HydroPWNics/footprints/README.md

# footprints
Common Footprint libraries previously stored as part of the analog sensor module repository
