HydroPWNics/footprints/3D/STEP/Molex 73251-1150 Assembly.stp

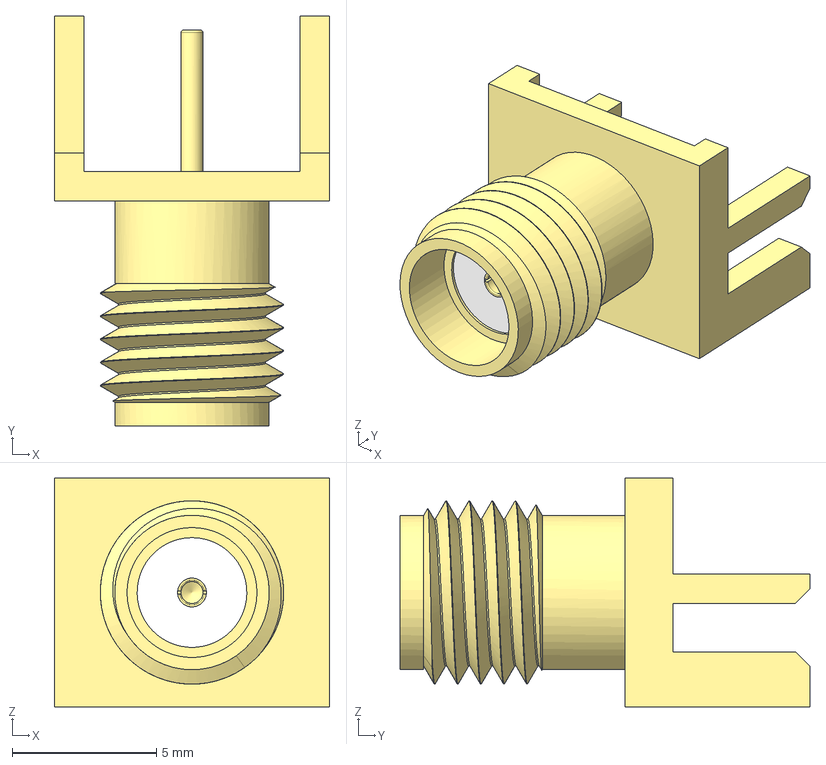
[picture p1: CAD file, 2016-11-11]
3D/STEP/Molex 73251-1150 Assembly.stp
9.53 x 14.2 x 7.93 mm
Molex 73251-1150 Part1
Molex 73251-1150 Part2
Molex 73251-1150 Part3
