HydroPWNics/footprints/3D/STEP/CAP_EEFC_G-M.stp

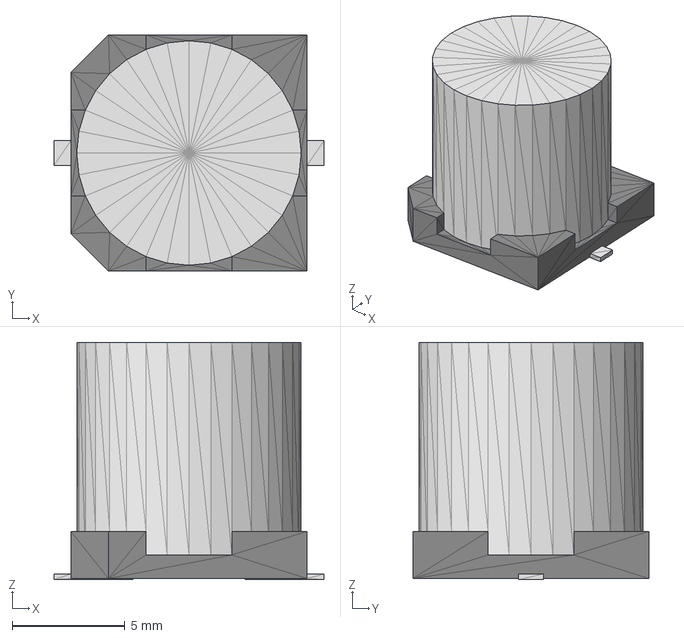
[picture p2: CAD file, 2017-02-14]
3D/STEP/CAP_EEFC_G-M.stp
12.0 x 10.5 x 10.5 mm
