HydroPWNics/footprints/3D/STEP/User Library-tsx-3225-1.step

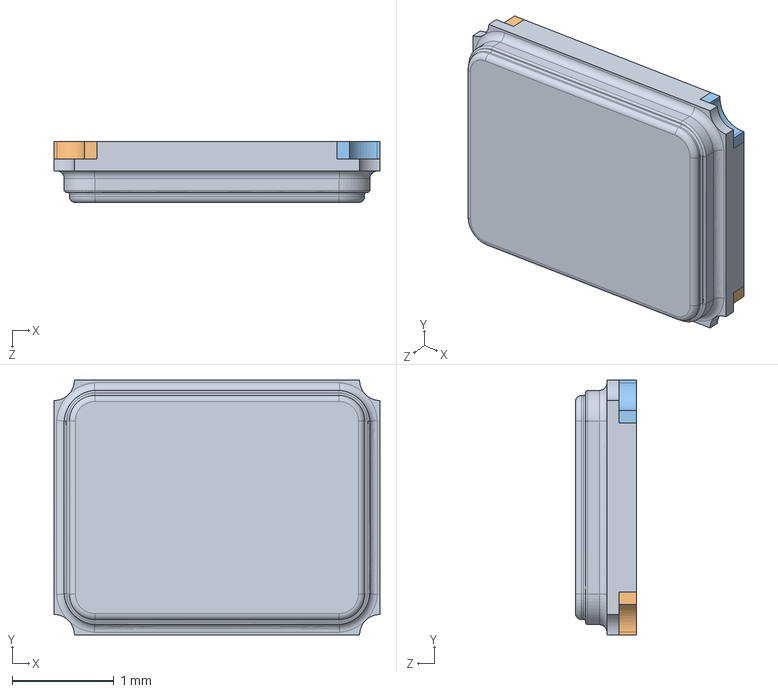
[picture p3: CAD file, 2017-02-06]
3D/STEP/User Library-tsx-3225-1.step
3.20 x 2.50 x 0.6 mm
