HydroPWNics/footprints/3D/STEP/ABS06.STEP

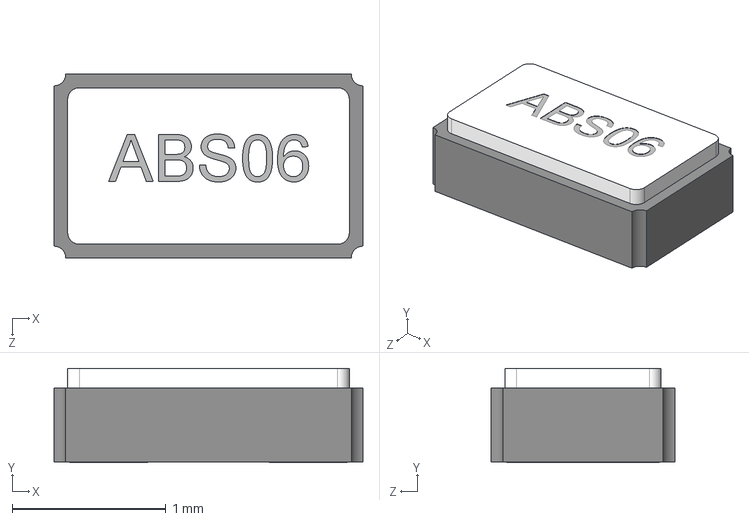
[picture p4: CAD file, 2017-01-24]
3D/STEP/ABS06.STEP
2.01 x 0.612 x 1.19 mm
