HydroPWNics/footprints/3D/STEP/Coilcraft-XAL6030.step

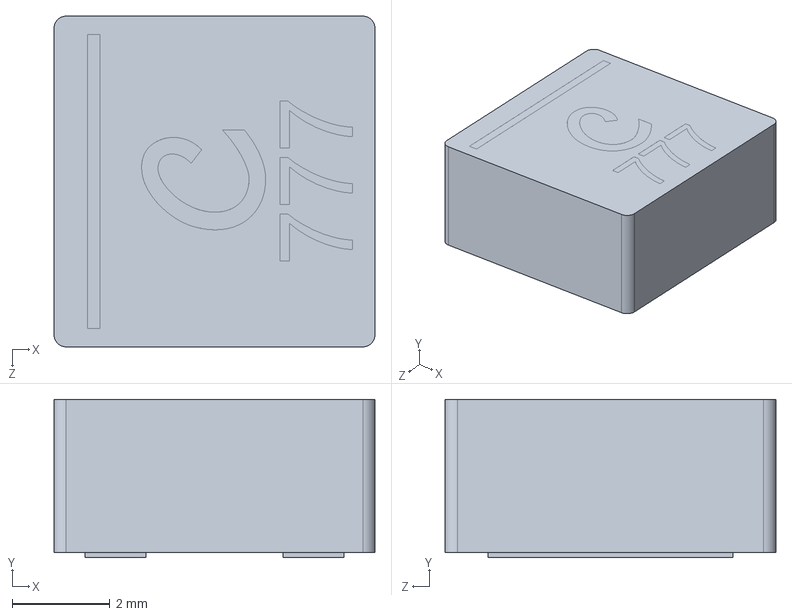
[picture p5: CAD file, 2017-01-24]
3D/STEP/Coilcraft-XAL6030.step
6.56 x 3.23 x 6.76 mm
