HydroPWNics/footprints/3D/STEP/VLCF5020T-100M1R1-1.step

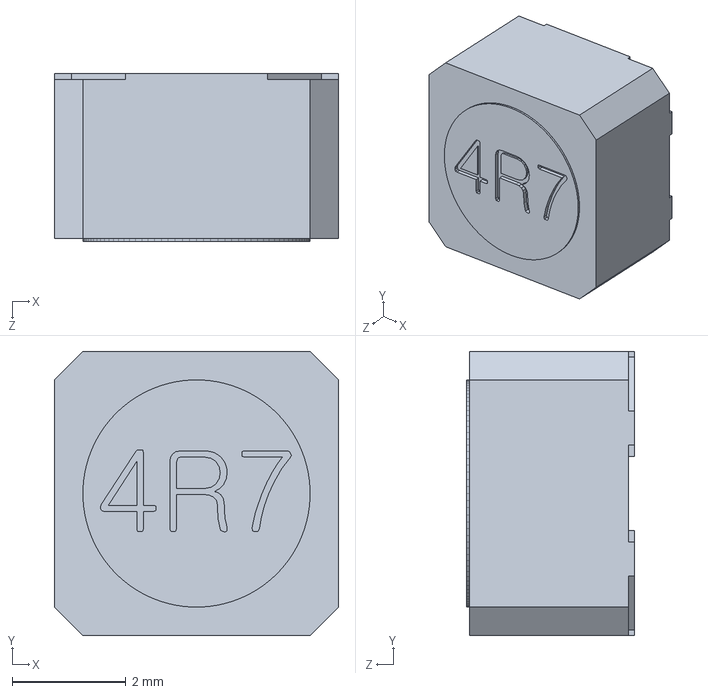
[picture p6: CAD file, 2017-01-24]
3D/STEP/VLCF5020T-100M1R1-1.step
5.00 x 5.00 x 2.95 mm
