HydroPWNics/footprints/3D/STEP/SML-LXLC1206.stp

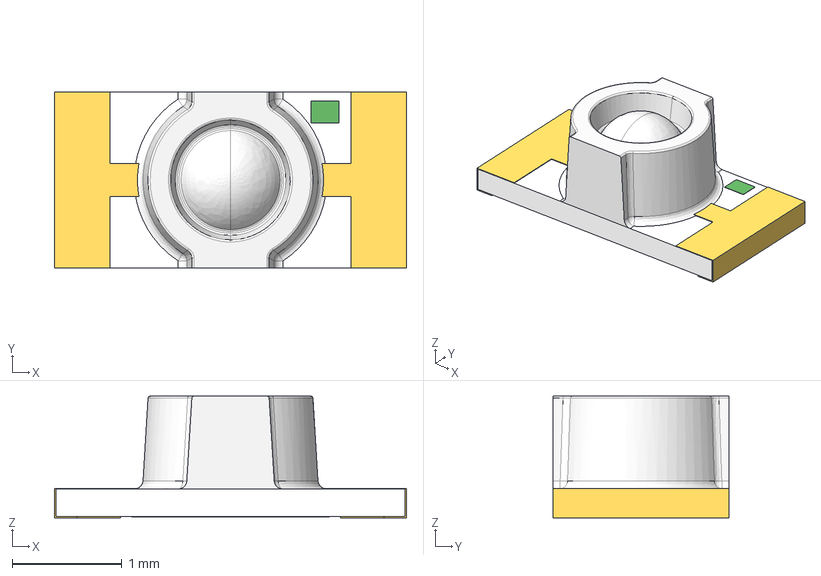
[picture p7: CAD file, 2017-01-13]
3D/STEP/SML-LXLC1206.stp
3.21 x 1.60 x 1.11 mm
