HydroPWNics/footprints/3D/STEP/Coilcraft-LPS3015.step

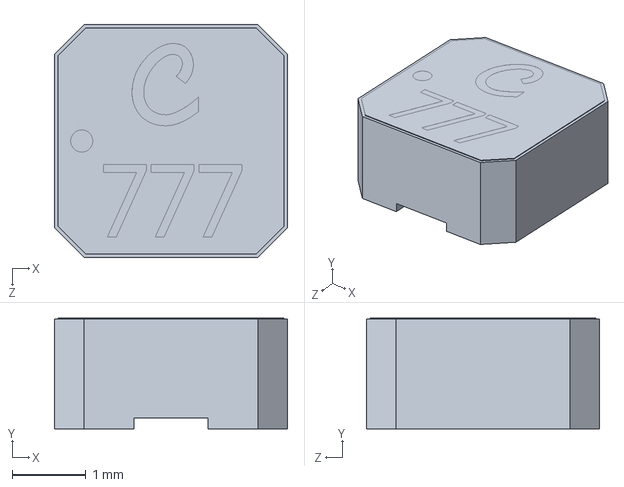
[picture p8: CAD file, 2017-01-09]
3D/STEP/Coilcraft-LPS3015.step
3.16 x 1.50 x 3.16 mm
