HydroPWNics/footprints/3D/STEP/C1210.step

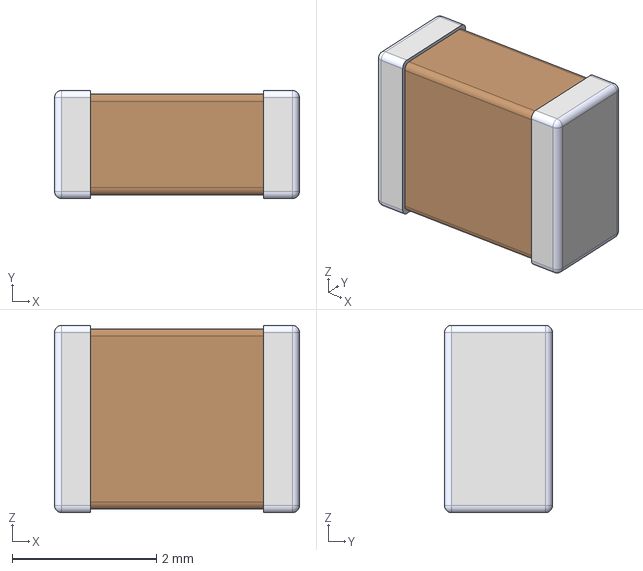
[picture p9: CAD file, 2017-01-09]
3D/STEP/C1210.step
3.40 x 1.50 x 2.60 mm
