HydroPWNics/footprints/3D/STEP/XFL4020.step

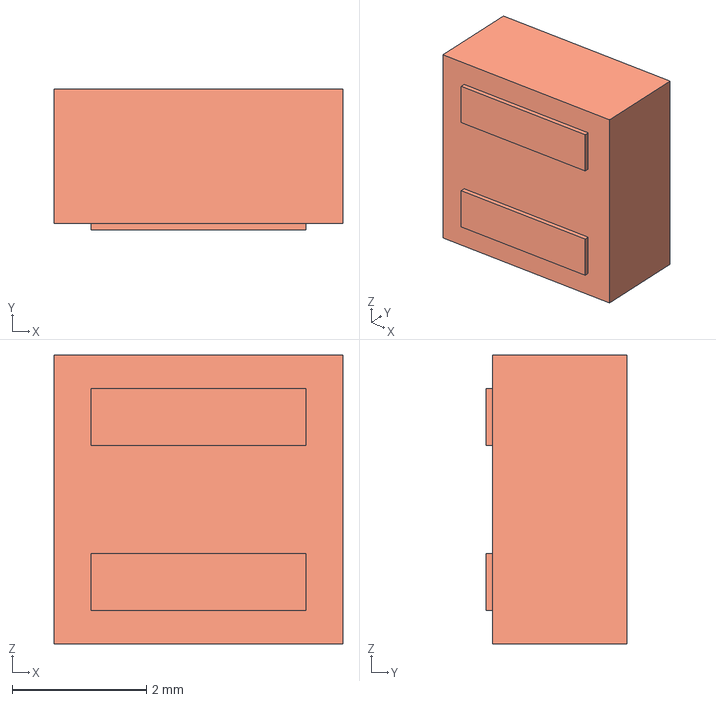
[picture p10: CAD file, 2017-01-09]
3D/STEP/XFL4020.step
4.30 x 2.10 x 4.30 mm
