HydroPWNics/footprints/3D/STEP/LQM2HP_J0.stp

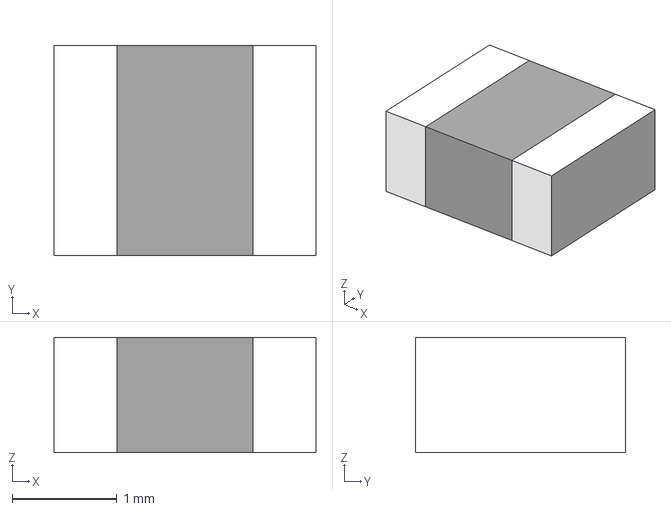
[picture p11: CAD file, 2017-01-09]
3D/STEP/LQM2HP_J0.stp
2.50 x 2.00 x 1.10 mm
