HydroPWNics/footprints/3D/STEP/SOIC4.step

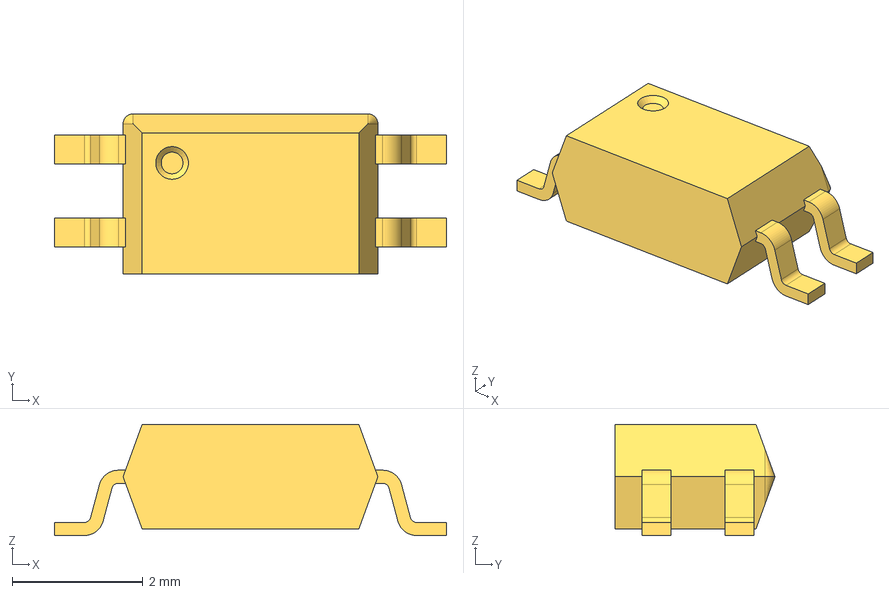
[picture p12: CAD file, 2017-01-04]
3D/STEP/SOIC4.step
6.00 x 2.45 x 1.70 mm
