HydroPWNics/footprints/3D/STEP/User Library-DO-214AA_SMB.step

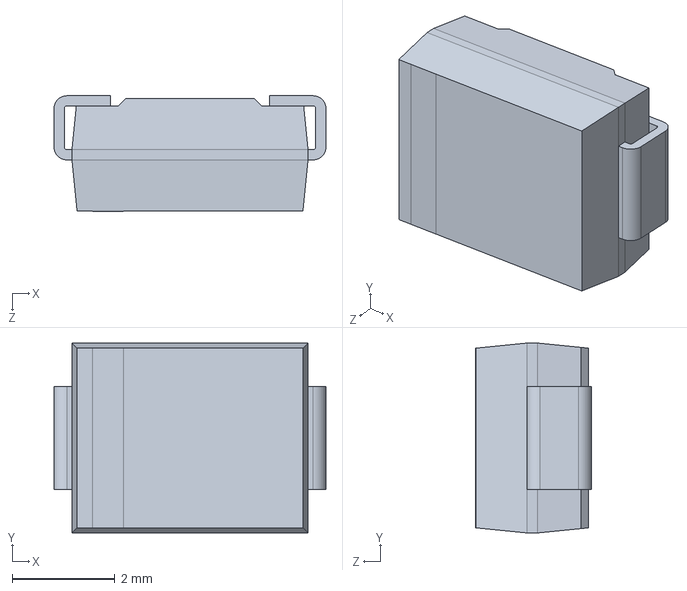
[picture p13: CAD file, 2017-01-04]
3D/STEP/User Library-DO-214AA_SMB.step
5.30 x 3.70 x 2.25 mm
