HydroPWNics/footprints/3D/STEP/1206_RES.stp

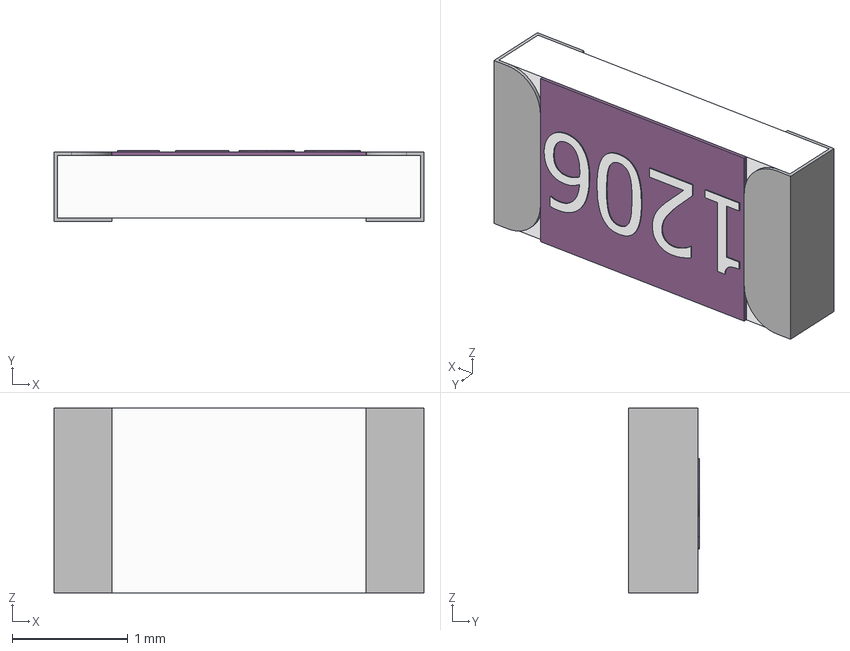
[picture p14: CAD file, 2017-01-04]
3D/STEP/1206_RES.stp
3.20 x 0.61 x 1.60 mm
Capsule
Encapsulation x 2
TopCover
