HydroPWNics/footprints/3D/STEP/0031-7701-11.STEP

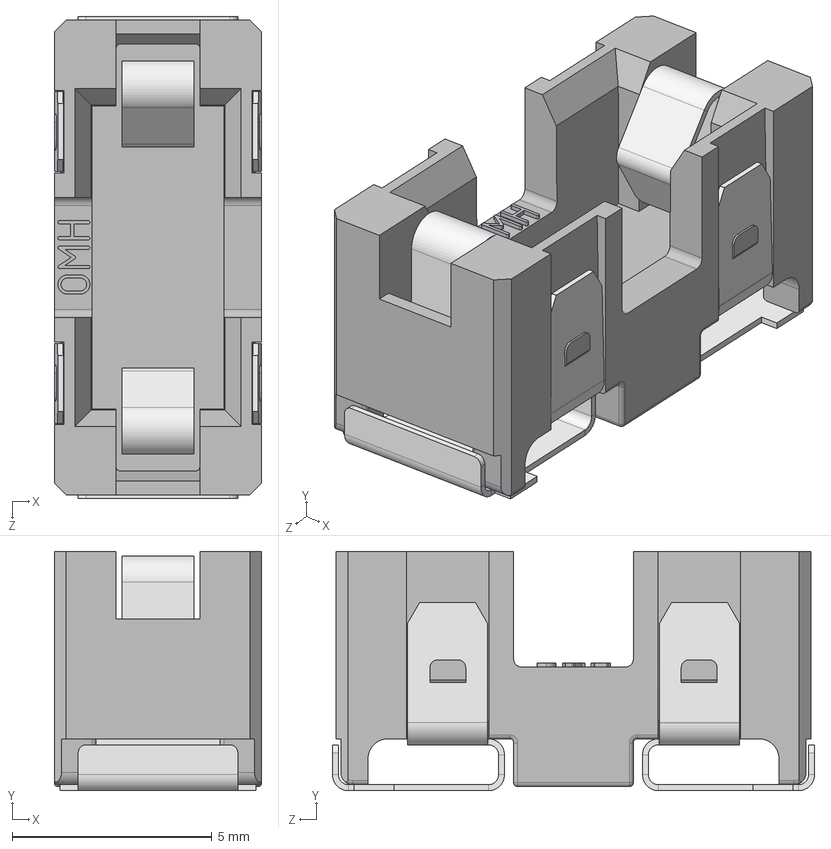
[picture p15: CAD file, 2017-01-04]
3D/STEP/0031-7701-11.STEP
5.20 x 6.00 x 12.1 mm
