HydroPWNics/footprints/3D/STEP/User Library-FSM4JSMATR - TE Connectivity - SPST 6mm Tactile Switch.step

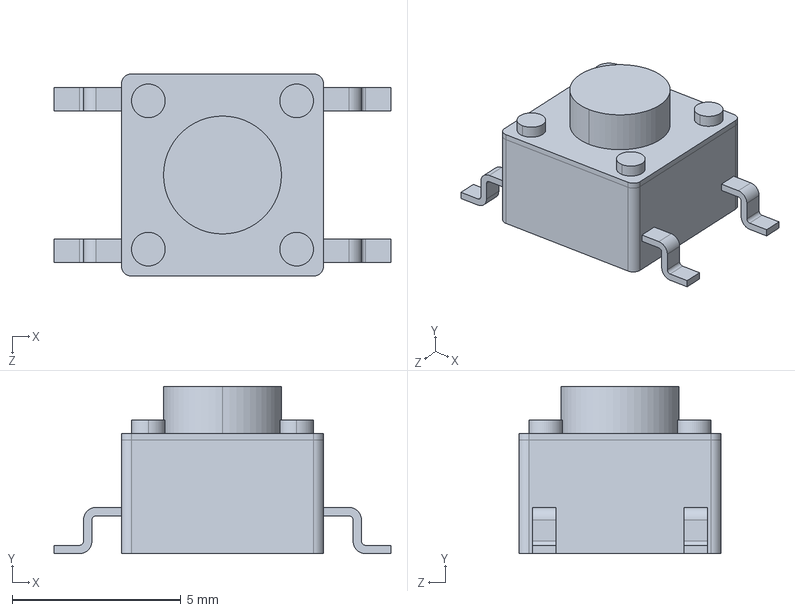
[picture p16: CAD file, 2017-01-04]
3D/STEP/User Library-FSM4JSMATR - TE Connectivity - SPST 6mm Tactile Switch.step
10.0 x 4.97 x 6.00 mm
