HydroPWNics/footprints/3D/STEP/NICHICON_ALU_CAP_1.step

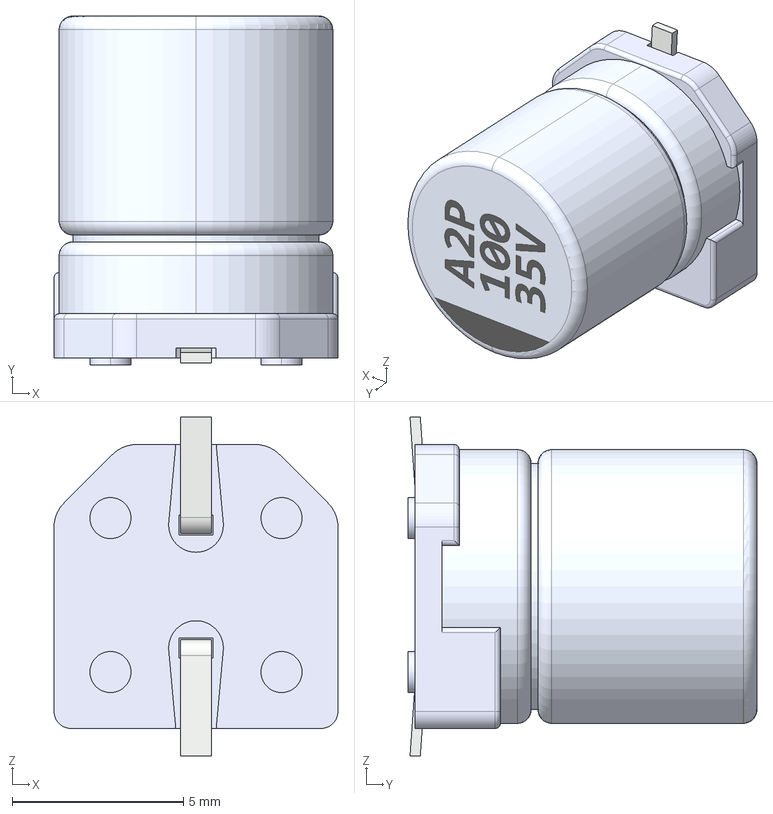
[picture p17: CAD file, 2016-12-30]
3D/STEP/NICHICON_ALU_CAP_1.step
8.30 x 10.2 x 9.90 mm
NICHIKON_UWT1V221MNL1GS
NICHIKON_UWT1V221MNL1GS001
NICHIKON_UWT1V221MNL1GS002
