HydroPWNics/footprints/3D/STEP/ABS05.STEP

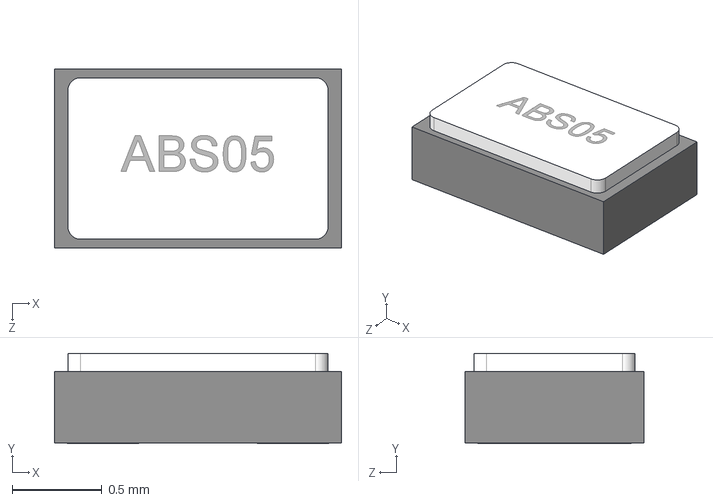
[picture p18: CAD file, 2016-12-30]
3D/STEP/ABS05.STEP
1.60 x 0.503 x 1.00 mm
