HydroPWNics/footprints/3D/STEP/S6B-PH-SM4-TB - S6B-PH-SM4.step

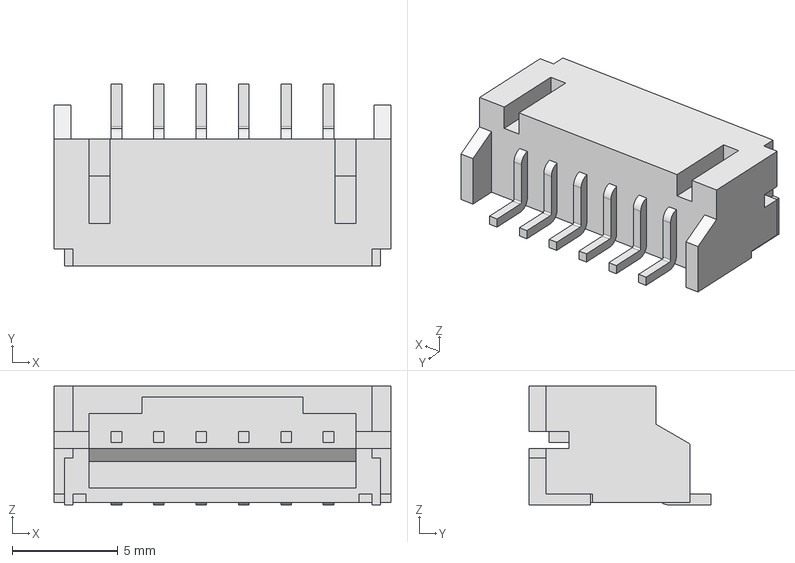
[picture p19: CAD file, 2016-12-30]
3D/STEP/S6B-PH-SM4-TB - S6B-PH-SM4.step
15.9 x 8.60 x 5.60 mm
