HydroPWNics/footprints/3D/STEP/sot-23-6.stp

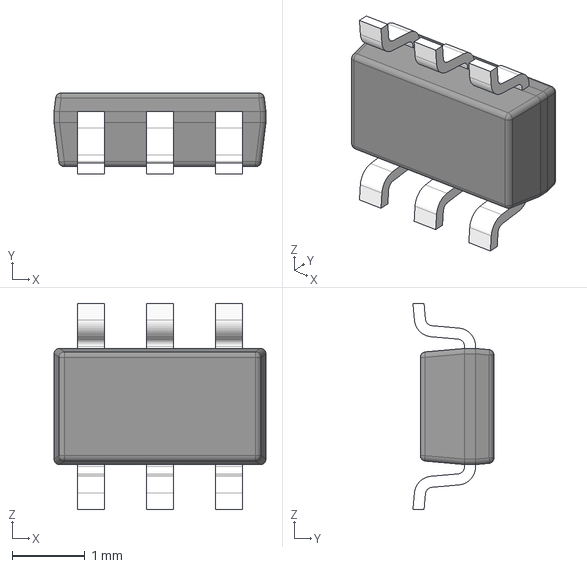
[picture p20: CAD file, 2016-12-30]
3D/STEP/sot-23-6.stp
2.92 x 1.12 x 2.84 mm
BODY_MF06A
LEAD_MF06A x 6
