HydroPWNics/footprints/3D/STEP/User Library-LTST-C193KFKT.step

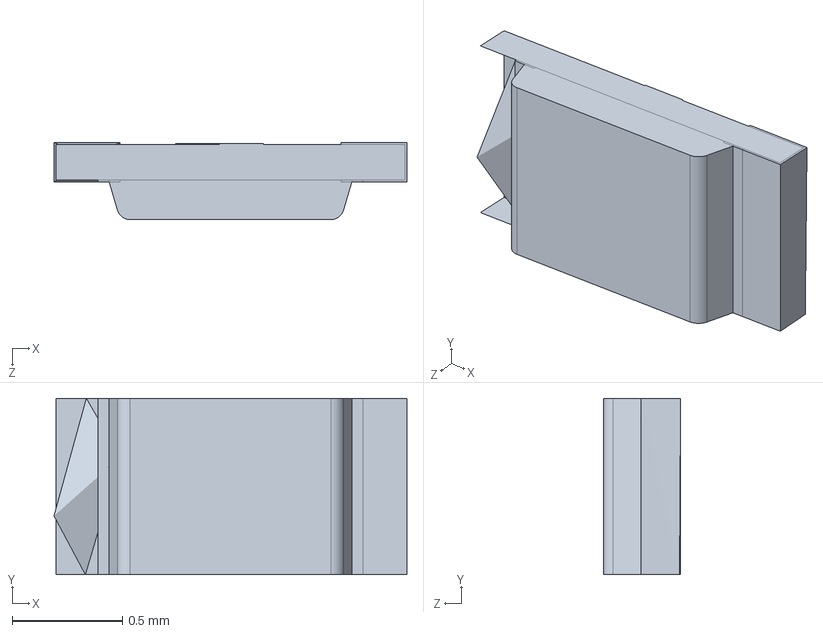
[picture p21: CAD file, 2016-12-30]
3D/STEP/User Library-LTST-C193KFKT.step
1.60 x 0.8 x 0.35 mm
