HydroPWNics/footprints/3D/STEP/S4B-PH-SM4-TB.STEP

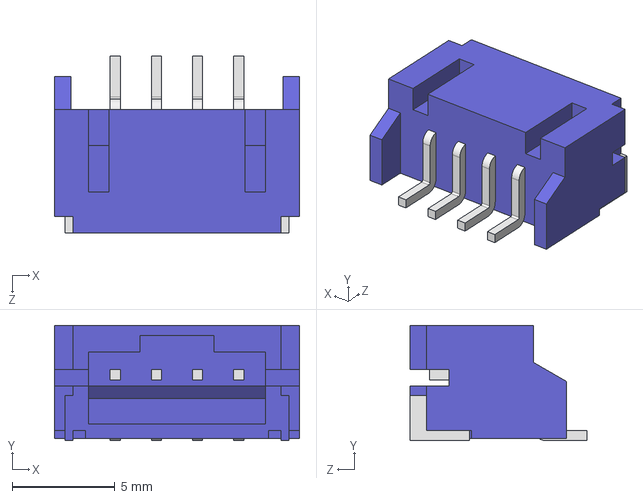
[picture p22: CAD file, 2016-12-30]
3D/STEP/S4B-PH-SM4-TB.STEP
11.9 x 5.60 x 8.60 mm
