HydroPWNics/footprints/3D/STEP/STEP-61301621121-rev1.stp

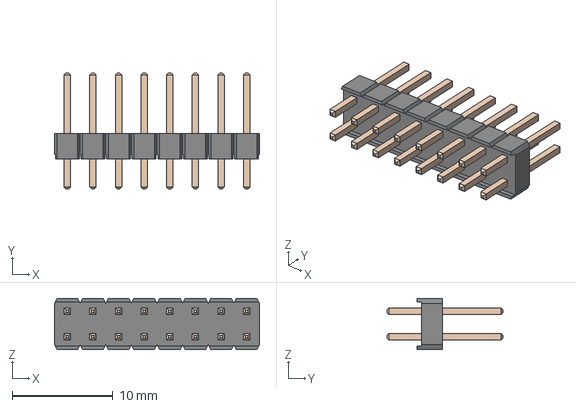
[picture p23: CAD file, 2016-12-30]
3D/STEP/STEP-61301621121-rev1.stp
20.3 x 11.5 x 5.08 mm
6130xx21121_PIN x 16
