HydroPWNics/footprints/3D/STEP/msop-10 - Part 1.step

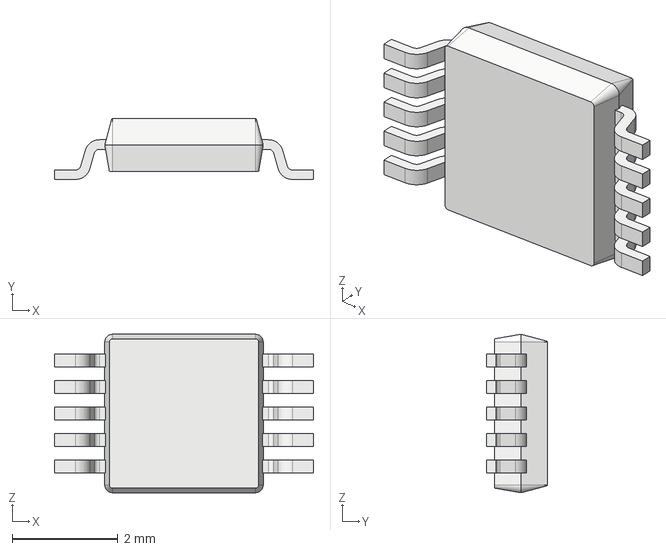
[picture p24: CAD file, 2016-12-30]
3D/STEP/msop-10 - Part 1.step
4.90 x 1.15 x 3.00 mm
