HydroPWNics/footprints/3D/STEP/Coilcraft-XFL3012.step

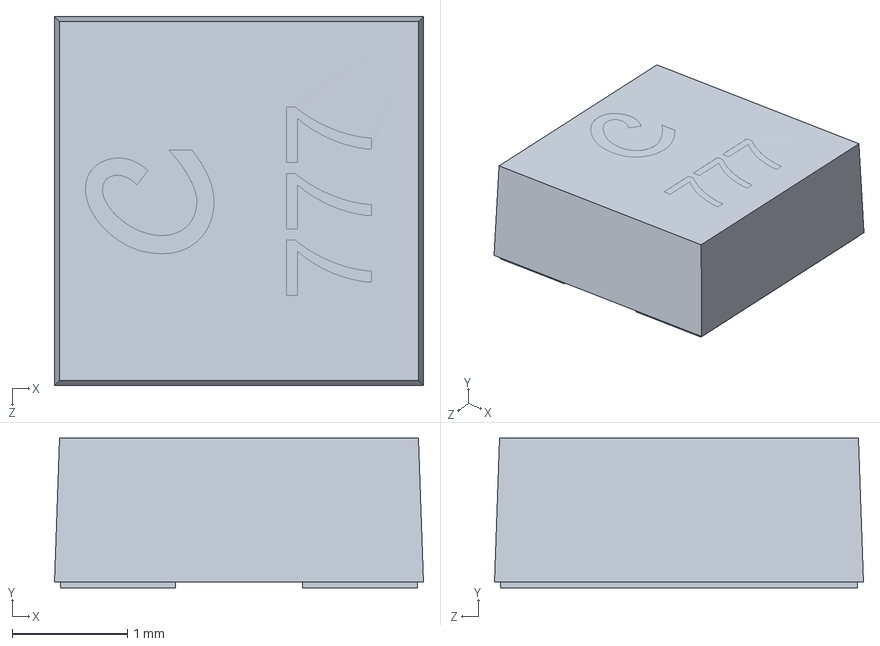
[picture p25: CAD file, 2016-12-30]
3D/STEP/Coilcraft-XFL3012.step
3.20 x 1.30 x 3.20 mm
