HydroPWNics/footprints/3D/STEP/User Library-LTST-C193NBKT.step

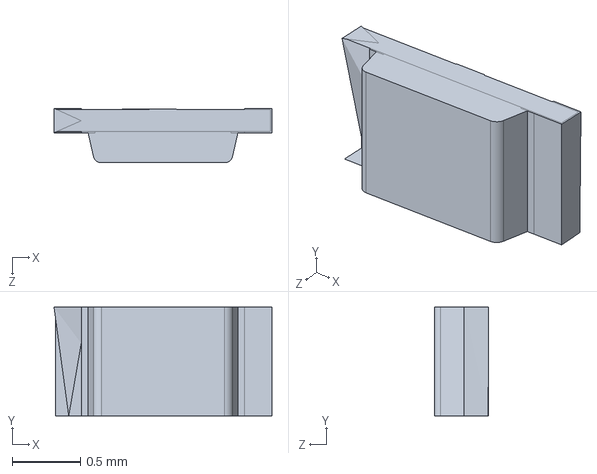
[picture p26: CAD file, 2016-12-30]
3D/STEP/User Library-LTST-C193NBKT.step
1.60 x 0.8 x 0.4 mm
