HydroPWNics/footprints/3D/STEP/TO263-7-1.stp

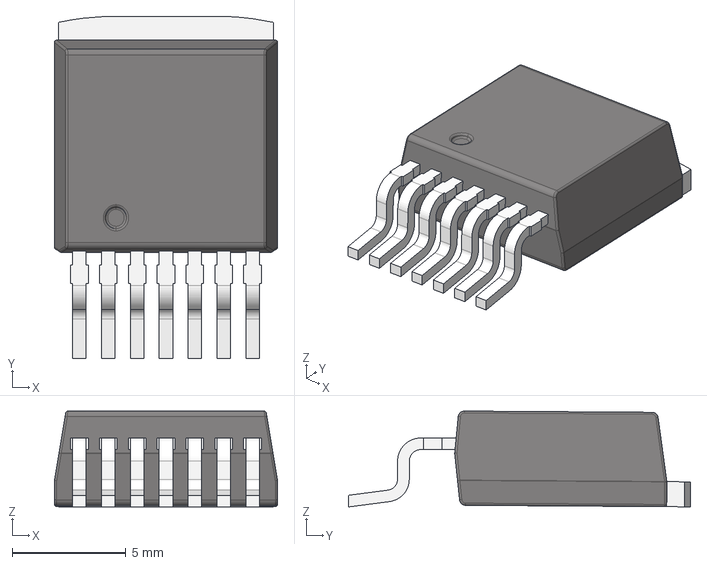
[picture p27: CAD file, 2016-12-30]
3D/STEP/TO263-7-1.stp
9.82 x 15.1 x 4.22 mm
