HydroPWNics/footprints/3D/STEP/STEP-36003200-rev1.stp

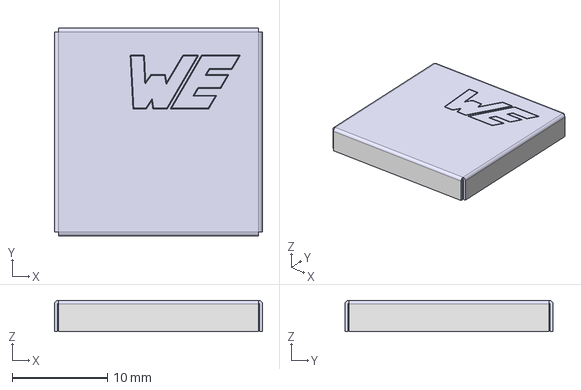
[picture p28: CAD file, 2016-11-11]
3D/STEP/STEP-36003200-rev1.stp
21.8 x 21.8 x 3.30 mm
