HydroPWNics/footprints/3D/STEP/ABM10_AP103.STEP

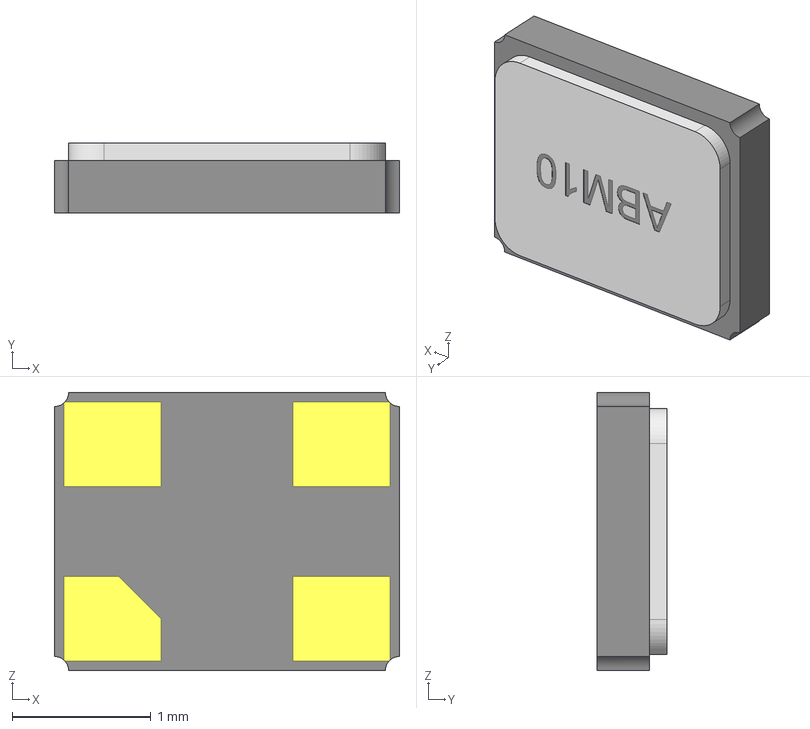
[picture p29: CAD file, 2016-11-11]
3D/STEP/ABM10_AP103.STEP
2.49 x 0.508 x 2.01 mm
