HydroPWNics/footprints/3D/STEP/User Library-ABM11.step

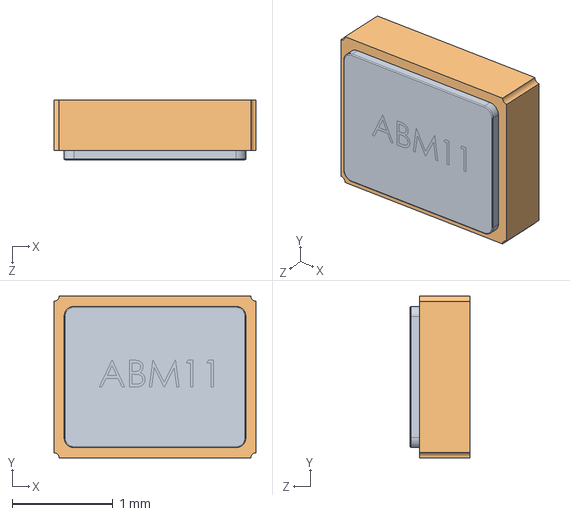
[picture p30: CAD file, 2016-11-11]
3D/STEP/User Library-ABM11.step
2.00 x 1.60 x 0.59 mm
