HydroPWNics/footprints/3D/STEP/MS-026ABA.stp

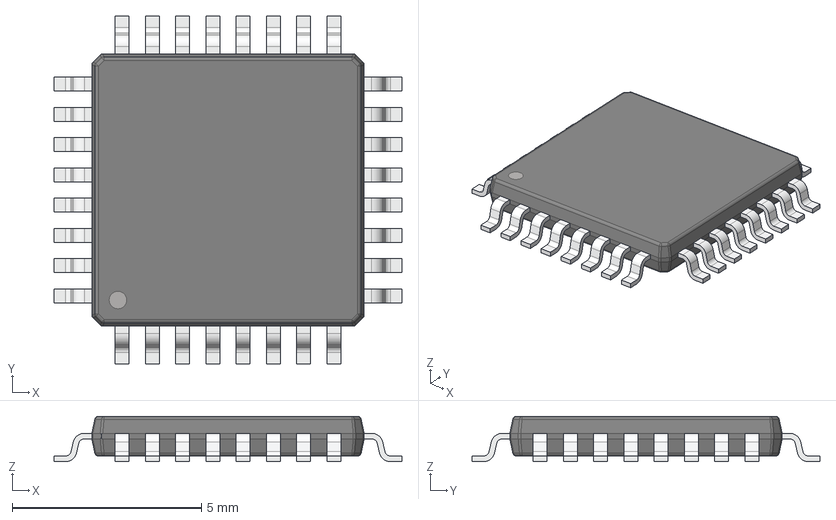
[picture p31: CAD file, 2016-11-11]
3D/STEP/MS-026ABA.stp
9.20 x 9.20 x 1.20 mm
