HydroPWNics/footprints/3D/STEP/Laird BMI-S-209-C.step

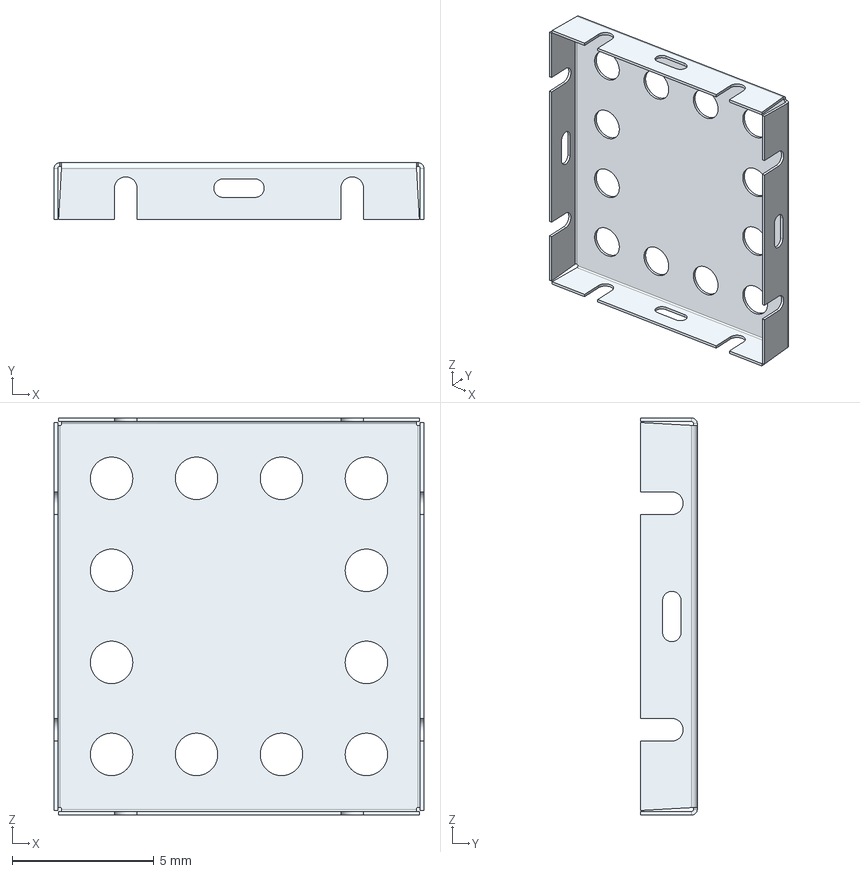
[picture p32: CAD file, 2016-11-11]
3D/STEP/Laird BMI-S-209-C.step
13.1 x 2.00 x 14.0 mm
