HydroPWNics/footprints/3D/STEP/MS-026ACB.stp

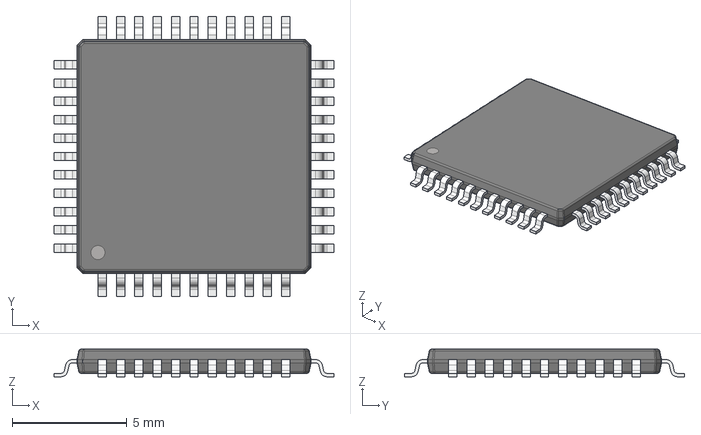
[picture p33: CAD file, 2016-11-11]
3D/STEP/MS-026ACB.stp
12.2 x 12.2 x 1.20 mm
