HydroPWNics/footprints/3D/STEP/TQFP48.step

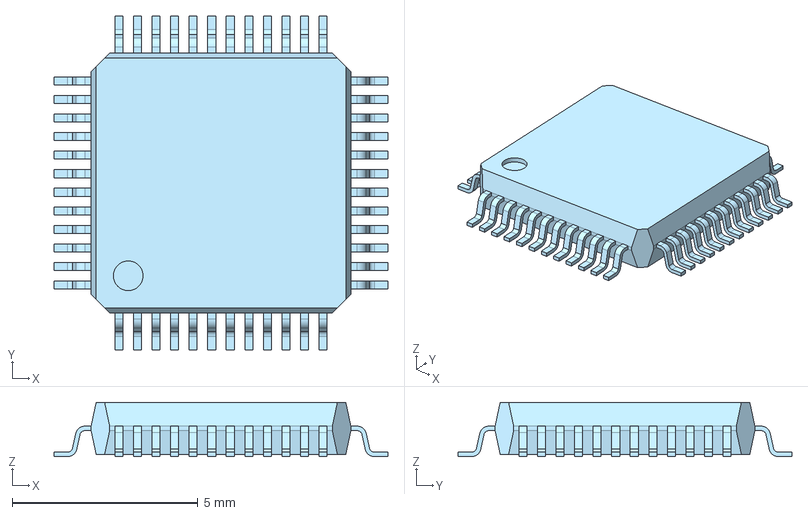
[picture p34: CAD file, 2016-11-11]
3D/STEP/TQFP48.step
9.00 x 9.00 x 1.46 mm
