HydroPWNics/footprints/3D/STEP/MS-026BED.stp

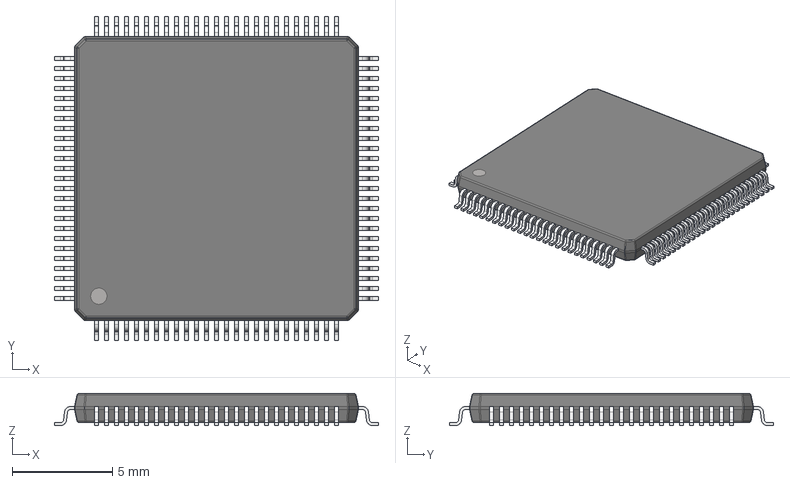
[picture p35: CAD file, 2016-11-11]
3D/STEP/MS-026BED.stp
16.2 x 16.2 x 1.60 mm
