HydroPWNics/footprints/3D/STEP/STEP-36103205-rev1 - 1.step

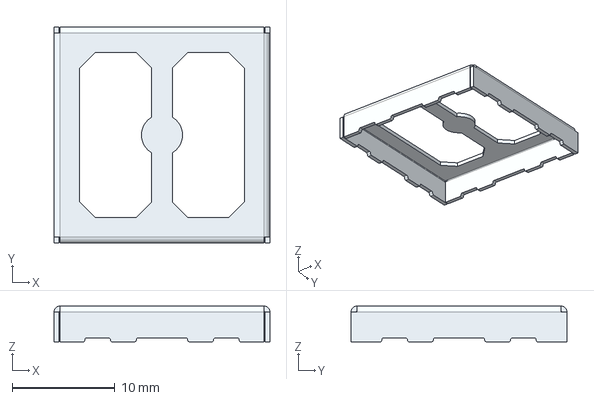
[picture p36: CAD file, 2016-11-11]
3D/STEP/STEP-36103205-rev1 - 1.step
21.0 x 21.0 x 3.50 mm
