HydroPWNics/footprints/3D/STEP/Laird BMI-S-209-F.step

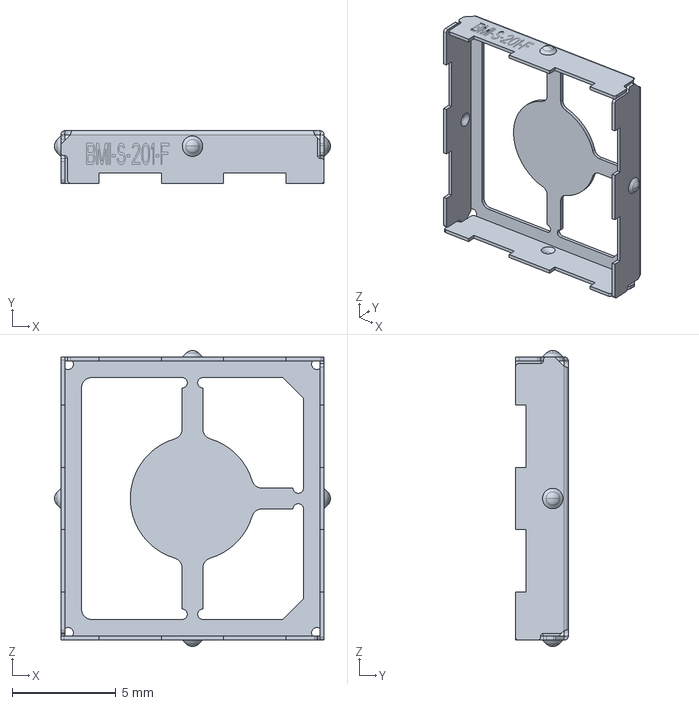
[picture p37: CAD file, 2016-11-11]
3D/STEP/Laird BMI-S-209-F.step
13.3 x 2.54 x 14.3 mm
