HydroPWNics/footprints/3D/STEP/ABM12.step

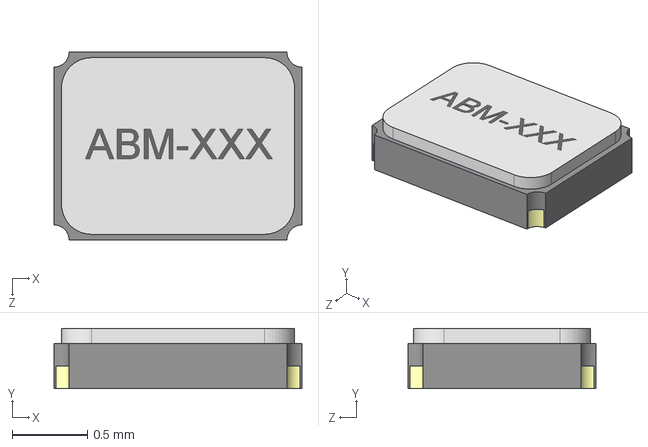
[picture p38: CAD file, 2016-11-11]
3D/STEP/ABM12.step
1.65 x 0.401 x 1.25 mm
