HydroPWNics/footprints/3D/STEP/SM06B-SRSS-TB.STEP

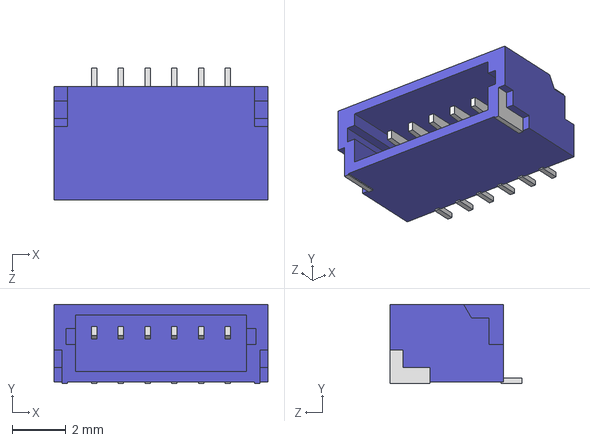
[picture p39: CAD file, 2016-11-11]
3D/STEP/SM06B-SRSS-TB.STEP
8.00 x 2.96 x 4.95 mm
