HydroPWNics/footprints/3D/STEP/TQFP-32_AP103.STEP

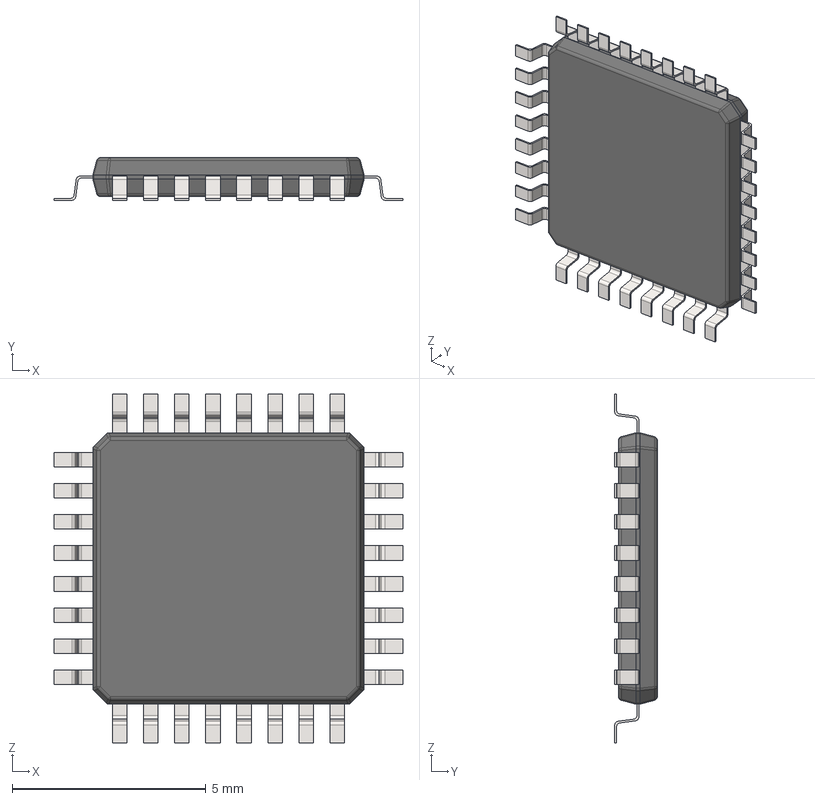
[picture p40: CAD file, 2016-11-11]
3D/STEP/TQFP-32_AP103.STEP
9.00 x 1.10 x 9.00 mm
