HydroPWNics/footprints/3D/STEP/User Library-DFN12(3x3).step

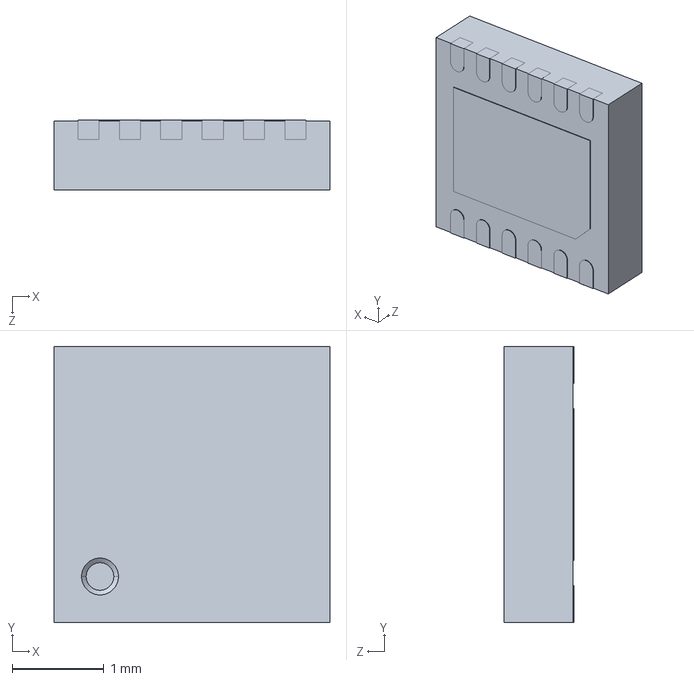
[picture p41: CAD file, 2016-11-11]
3D/STEP/User Library-DFN12(3x3).step
3.00 x 3.00 x 0.76 mm
