HydroPWNics/footprints/3D/STEP/SOT23-5.stp

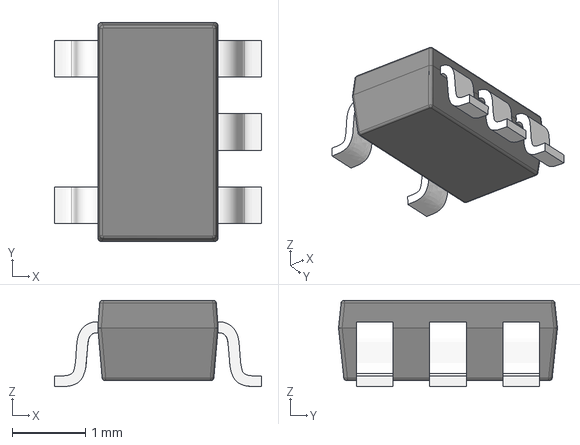
[picture p42: CAD file, 2016-10-31]
3D/STEP/SOT23-5.stp
2.84 x 3.00 x 1.18 mm
