HydroPWNics/footprints/3D/STEP/Johanson_Tech_Balun.step

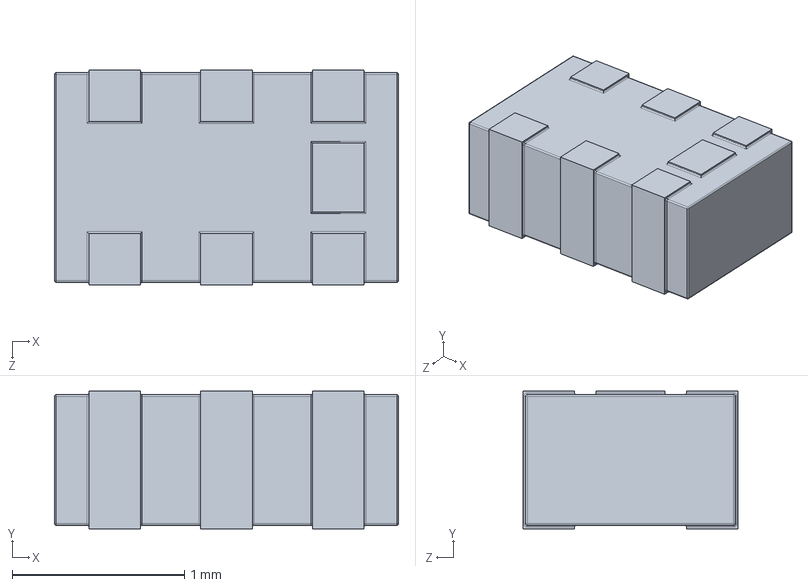
[picture p43: CAD file, 2016-10-30]
3D/STEP/Johanson_Tech_Balun.step
2.00 x 0.8 x 1.25 mm
