HydroPWNics/footprints/3D/STEP/Coilcraft-0402CS.step

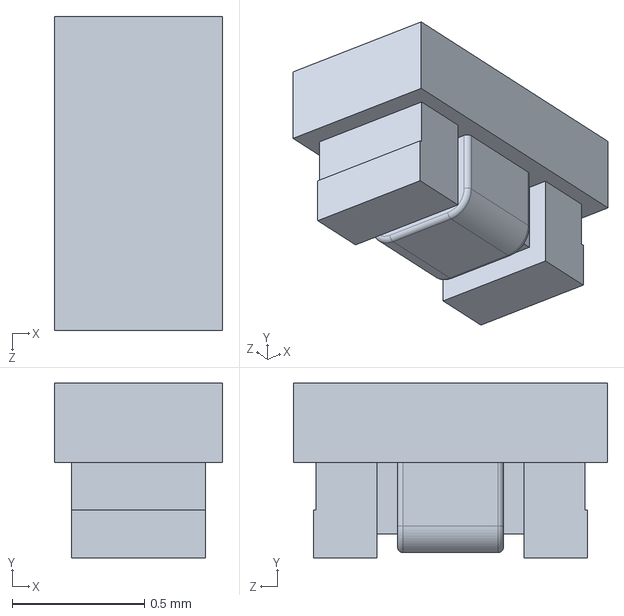
[picture p44: CAD file, 2016-10-29]
3D/STEP/Coilcraft-0402CS.step
0.636 x 0.66 x 1.19 mm
