HydroPWNics/footprints/3D/STEP/CSS-1210TB.stp

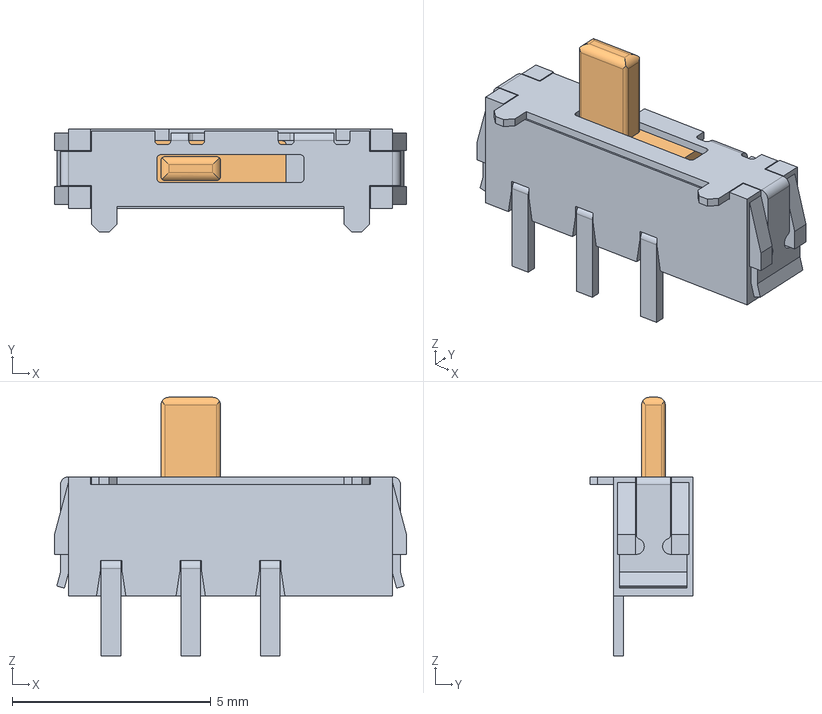
[picture p45: CAD file, 2016-10-28]
3D/STEP/CSS-1210TB.stp
8.85 x 2.60 x 6.50 mm
_CSS-1210TB-b
_CSS-1210TB-s
