HydroPWNics/footprints/3D/STEP/SOIC10 narrow.stp

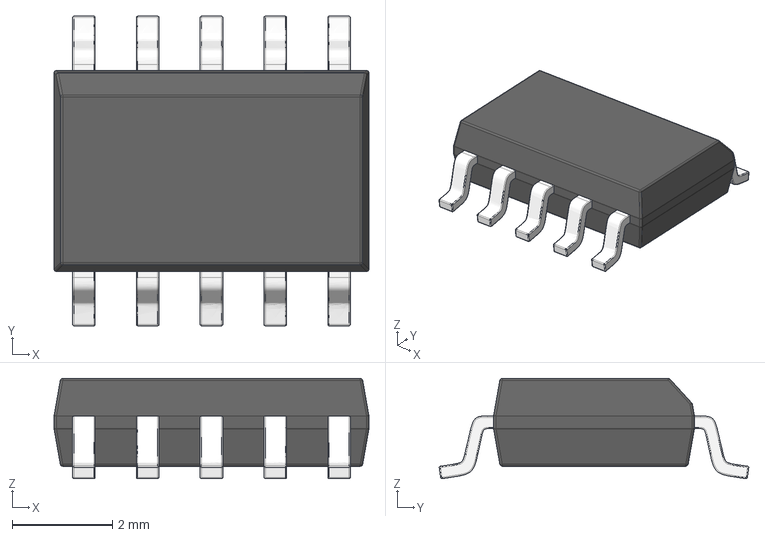
[picture p46: CAD file, 2016-10-28]
3D/STEP/SOIC10 narrow.stp
6.27 x 6.16 x 2.00 mm
