HydroPWNics/footprints/3D/STEP/SOIC14 narrow.stp

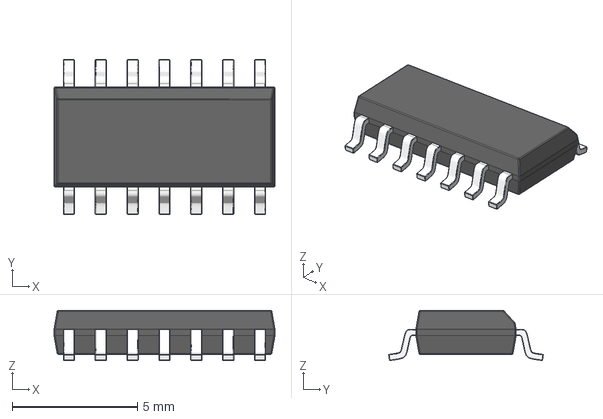
[picture p47: CAD file, 2016-10-28]
3D/STEP/SOIC14 narrow.stp
8.81 x 6.16 x 2.00 mm
