HydroPWNics/footprints/3D/STEP/CUS-12TB.stp

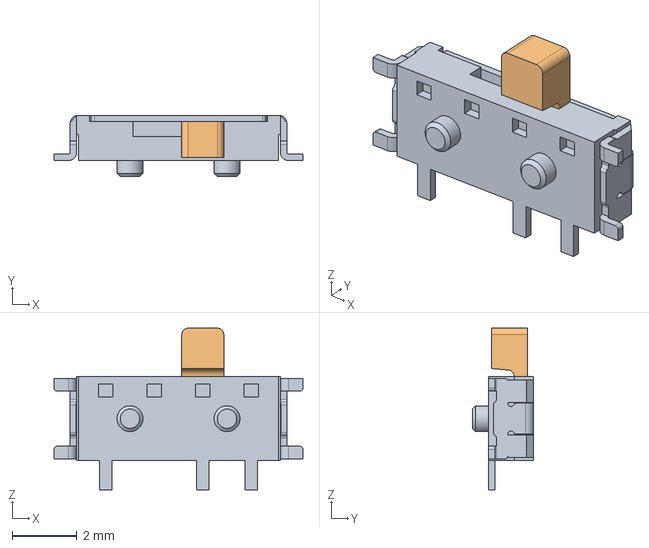
[picture p48: CAD file, 2016-10-28]
3D/STEP/CUS-12TB.stp
7.70 x 1.90 x 5.00 mm
_CUS-12-body
_CUS-12-slider
