HydroPWNics/footprints/3D/STEP/SOIC08 narrow.stp

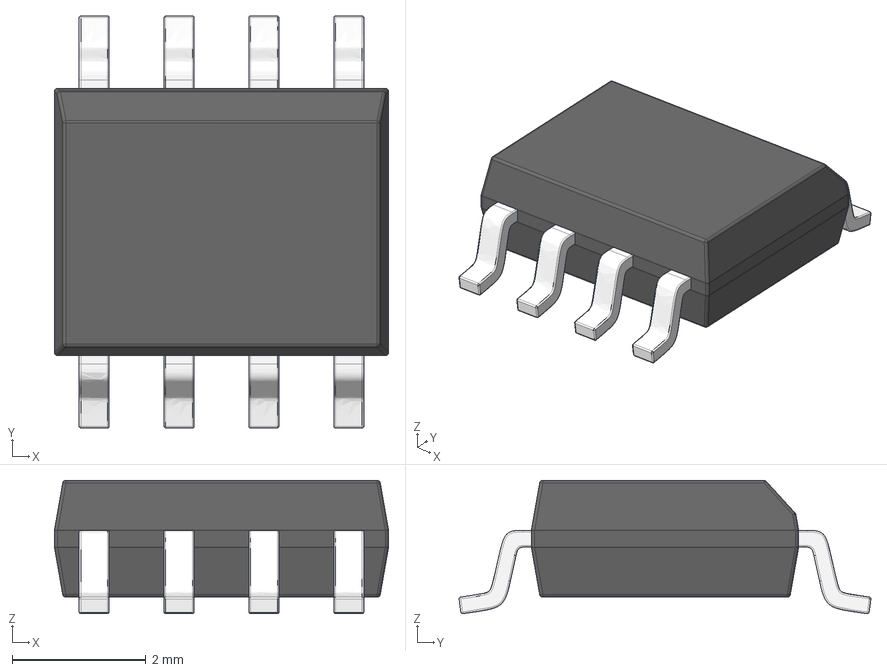
[picture p49: CAD file, 2016-10-28]
3D/STEP/SOIC08 narrow.stp
5.00 x 6.16 x 2.00 mm
