HydroPWNics/footprints/3D/STEP/SOIC16 narrow.stp

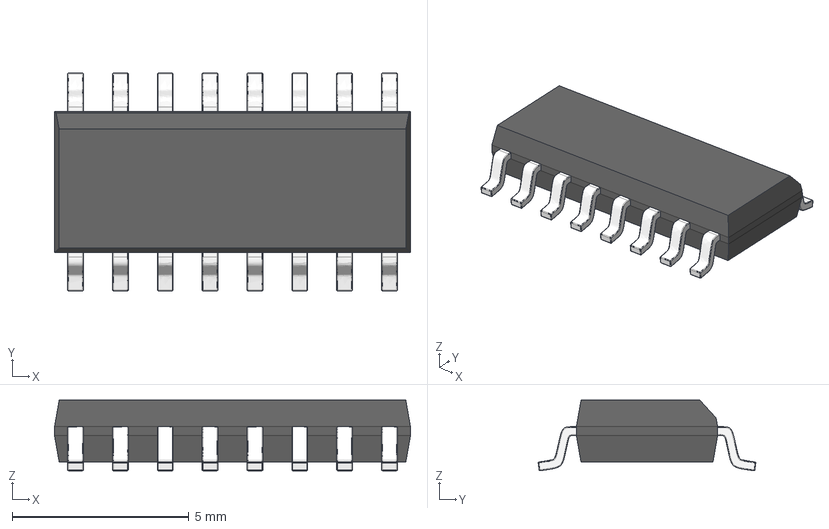
[picture p50: CAD file, 2016-10-28]
3D/STEP/SOIC16 narrow.stp
10.1 x 6.16 x 2.00 mm
