HydroPWNics/footprints/3D/STEP/User Library-ESP_12_E.STEP

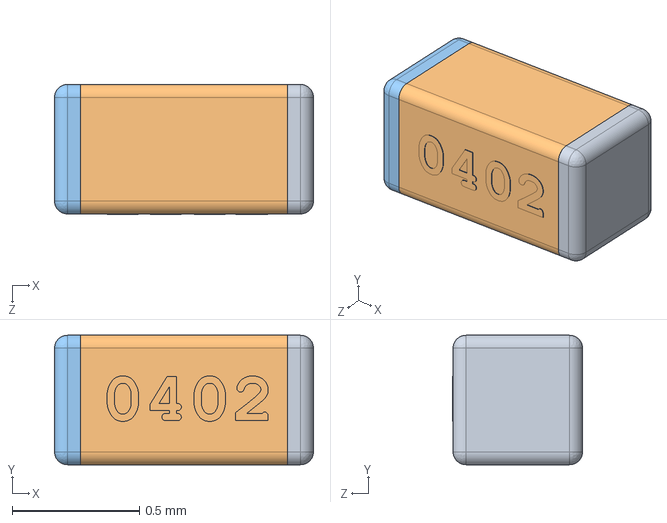
[picture p51: CAD file, 2016-10-18]
3D/STEP/User Library-ESP_12_E.STEP
1.02 x 0.508 x 0.511 mm
