HydroPWNics/footprints/3D/STEP/WIN_SS-8-M.stp

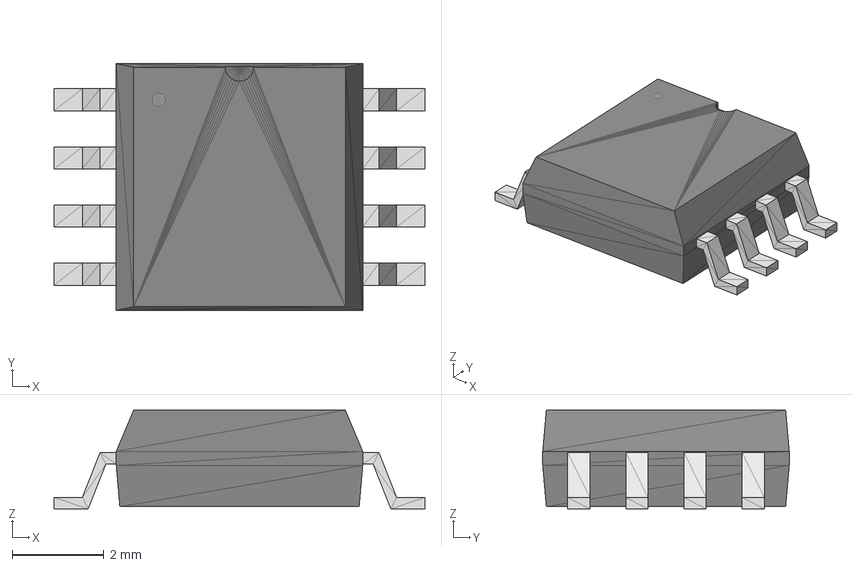
[picture p52: CAD file, 2016-10-18]
3D/STEP/WIN_SS-8-M.stp
8.10 x 5.38 x 2.16 mm
