HydroPWNics/footprints/3D/STEP/WIN_ZP-8-M.stp

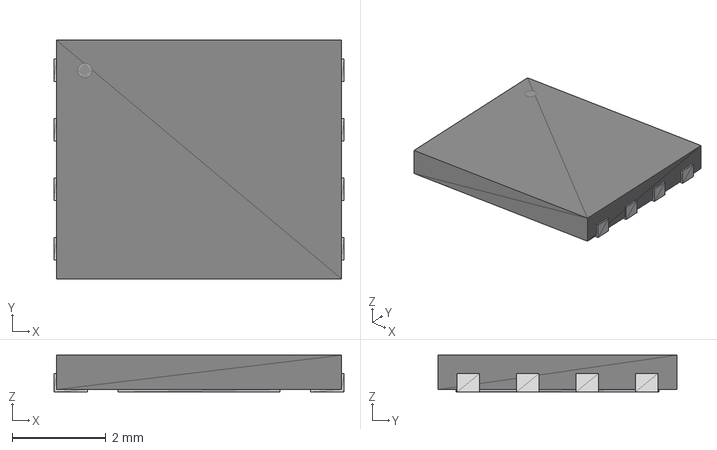
[picture p53: CAD file, 2016-10-14]
3D/STEP/WIN_ZP-8-M.stp
6.20 x 5.11 x 0.79 mm
