HydroPWNics/footprints/3D/STEP/S3B-PH-K-S.STEP

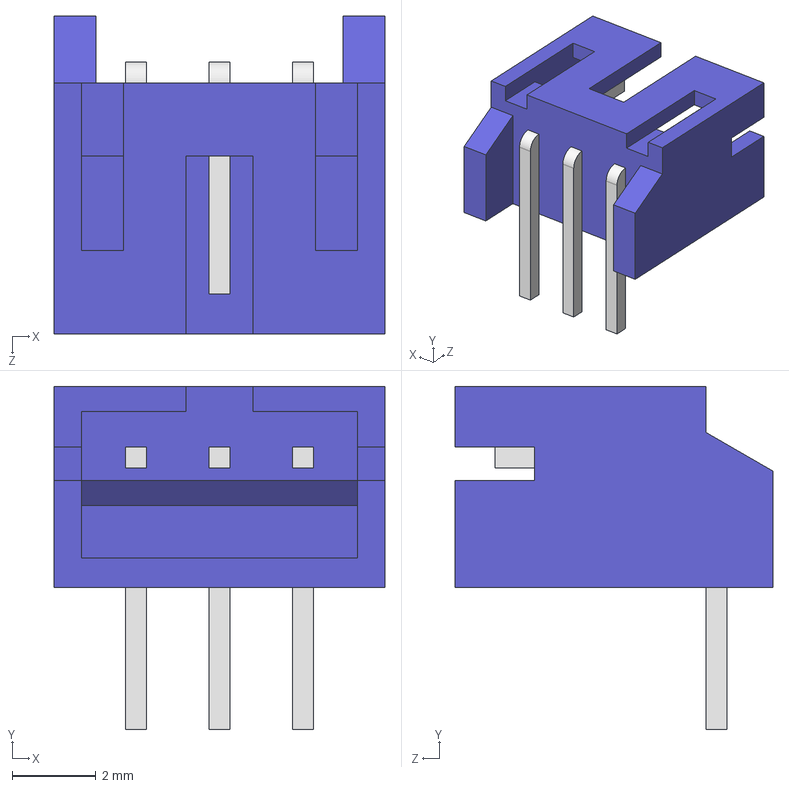
[picture p54: CAD file, 2016-10-14]
3D/STEP/S3B-PH-K-S.STEP
7.90 x 8.20 x 7.60 mm
