HydroPWNics/footprints/3D/STEP/User Library-QFN48_7x7.step

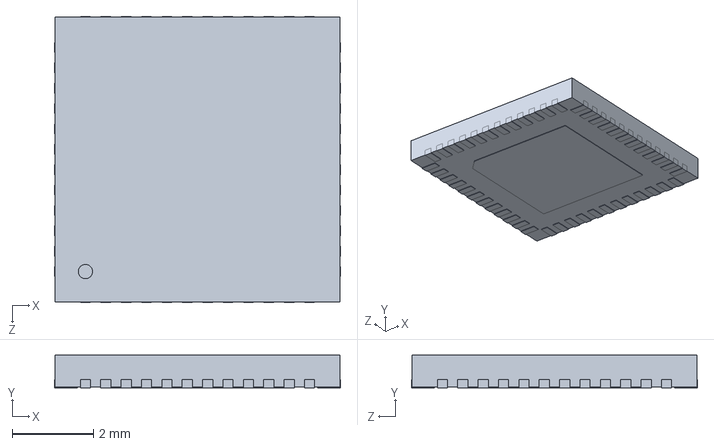
[picture p55: CAD file, 2016-10-14]
3D/STEP/User Library-QFN48_7x7.step
7.02 x 0.8 x 7.02 mm
