HydroPWNics/footprints/3D/STEP/S2B-PH-K-S.STEP

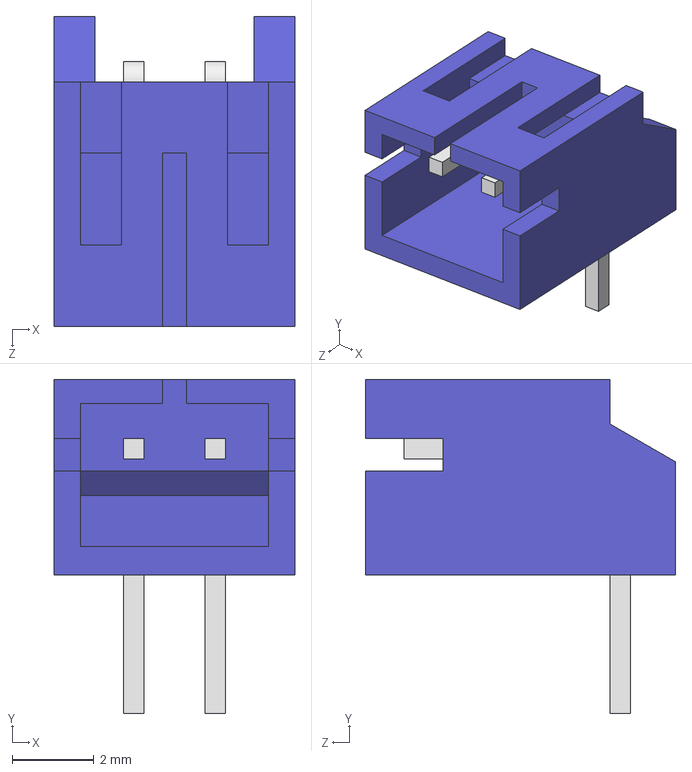
[picture p56: CAD file, 2016-10-14]
3D/STEP/S2B-PH-K-S.STEP
5.90 x 8.20 x 7.60 mm
