HydroPWNics/footprints/3D/STEP/QFN-32 V6.stp

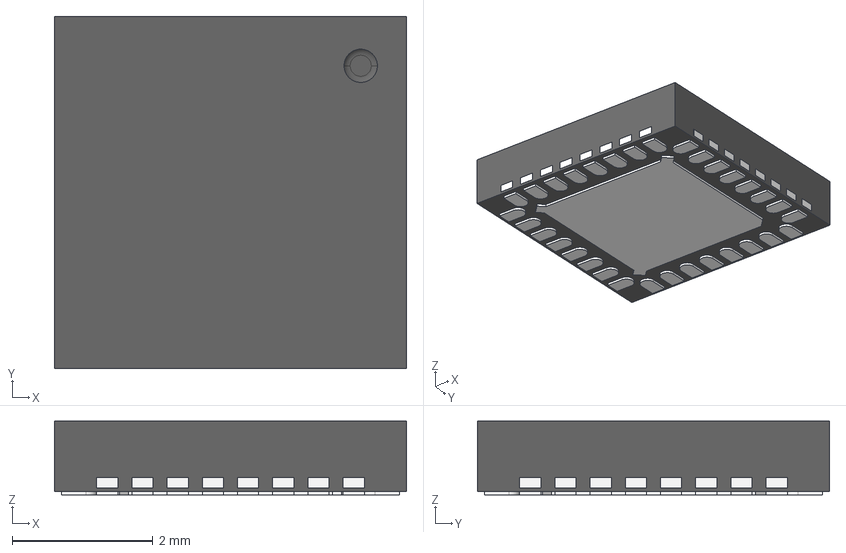
[picture p57: CAD file, 2016-09-30]
3D/STEP/QFN-32 V6.stp
5.00 x 5.00 x 1.05 mm
