HydroPWNics/footprints/3D/STEP/SOT23-3.stp

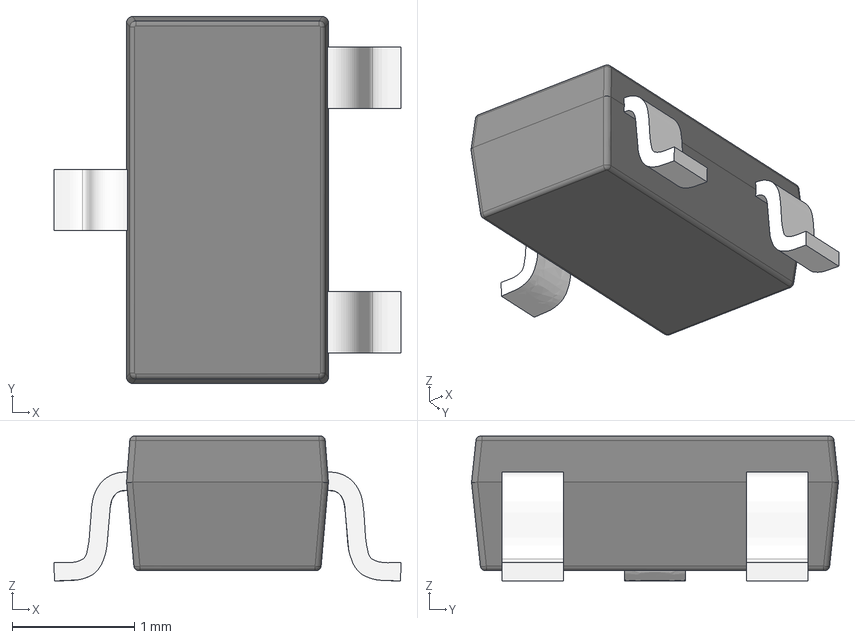
[picture p58: CAD file, 2016-09-29]
3D/STEP/SOT23-3.stp
2.84 x 3.00 x 1.18 mm
