HydroPWNics/footprints/3D/STEP/c-1909763-1-b-3d.stp

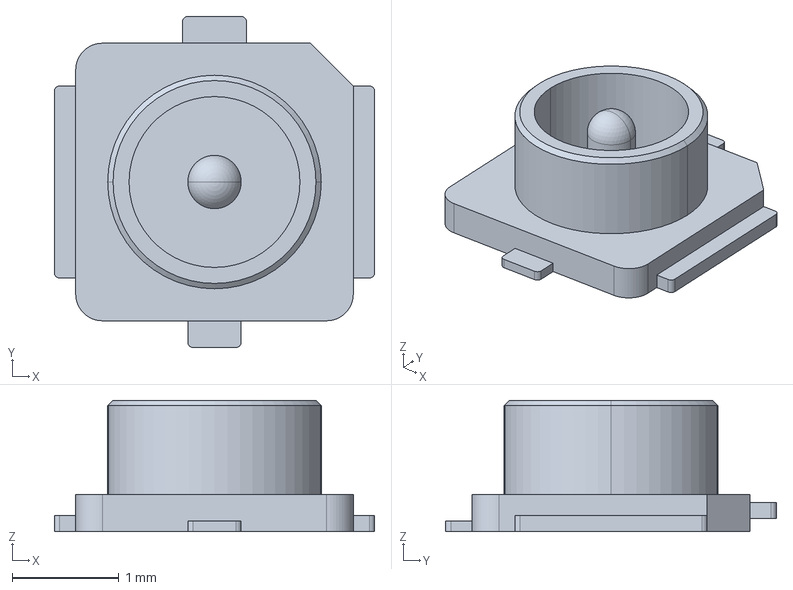
[picture p59: CAD file, 2016-09-29]
3D/STEP/c-1909763-1-b-3d.stp
3.00 x 3.10 x 1.23 mm
