HydroPWNics/footprints/3D/STEP/SOD-123FL.STEP

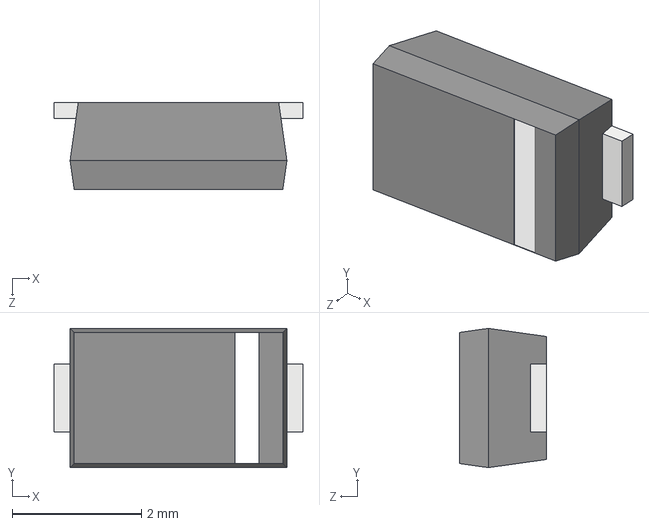
[picture p60: CAD file, 2016-09-29]
3D/STEP/SOD-123FL.STEP
3.85 x 2.15 x 1.35 mm
