HydroPWNics/footprints/3D/STEP/ABS07.STEP

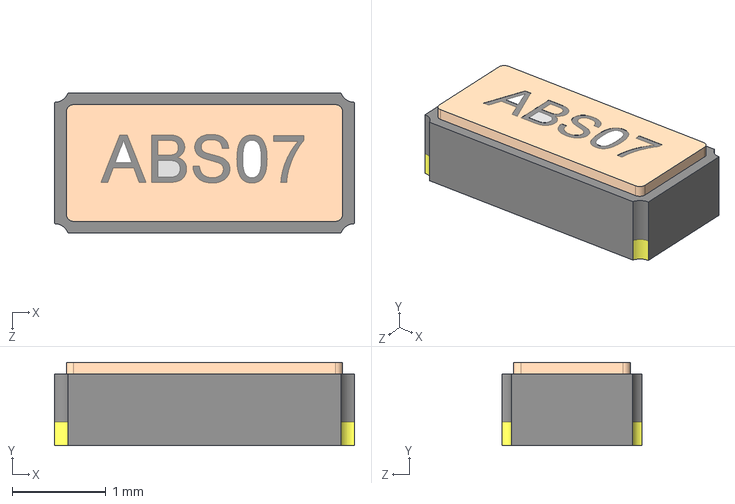
[picture p61: CAD file, 2016-09-29]
3D/STEP/ABS07.STEP
3.20 x 0.889 x 1.50 mm
