HydroPWNics/footprints/3D/STEP/ABM3B.STEP

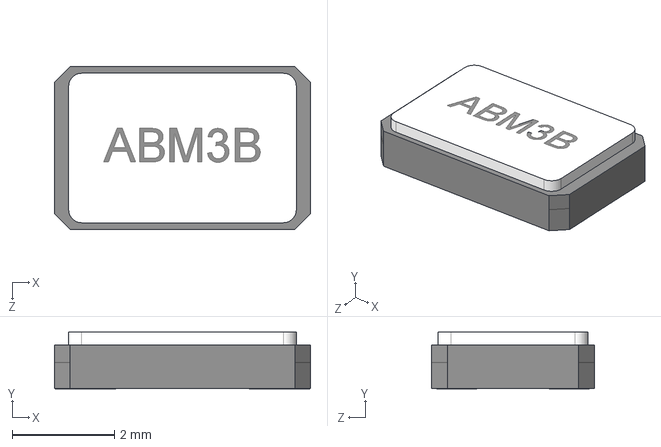
[picture p62: CAD file, 2016-09-29]
3D/STEP/ABM3B.STEP
5.00 x 1.11 x 3.18 mm
