HydroPWNics/footprints/3D/STEP/SOD-323.STEP

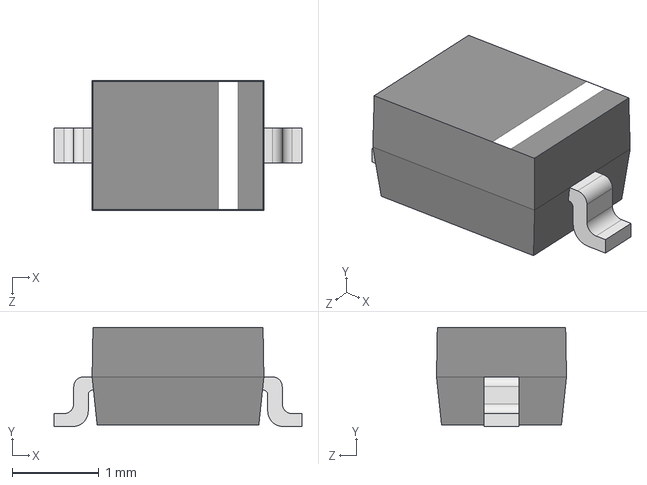
[picture p63: CAD file, 2016-09-29]
3D/STEP/SOD-323.STEP
2.86 x 1.14 x 1.50 mm
