HydroPWNics/footprints/3D/STEP/B2B-PH-K-S.STEP

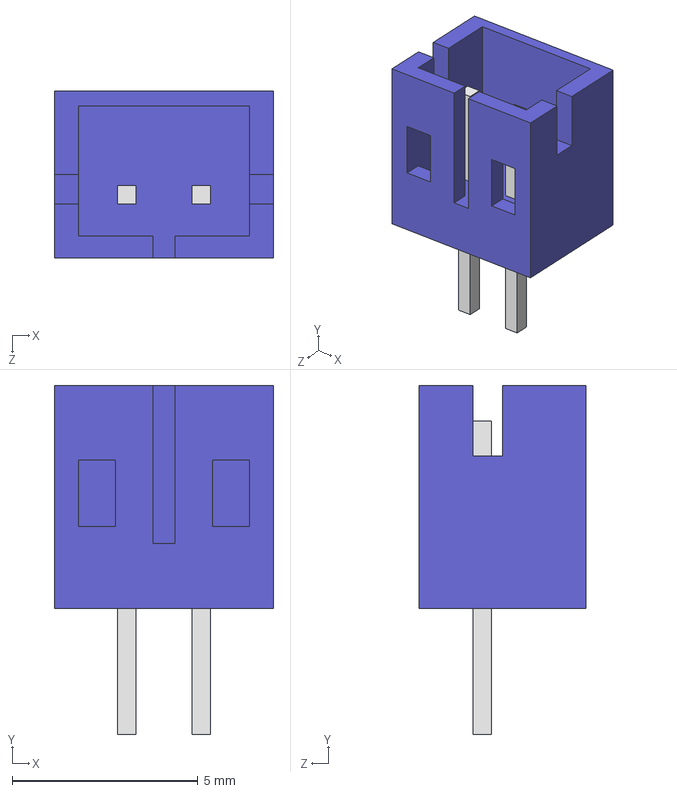
[picture p64: CAD file, 2016-09-23]
3D/STEP/B2B-PH-K-S.STEP
5.90 x 9.40 x 4.50 mm
