HydroPWNics/footprints/3D/STEP/User Library-lqpf64.STEP

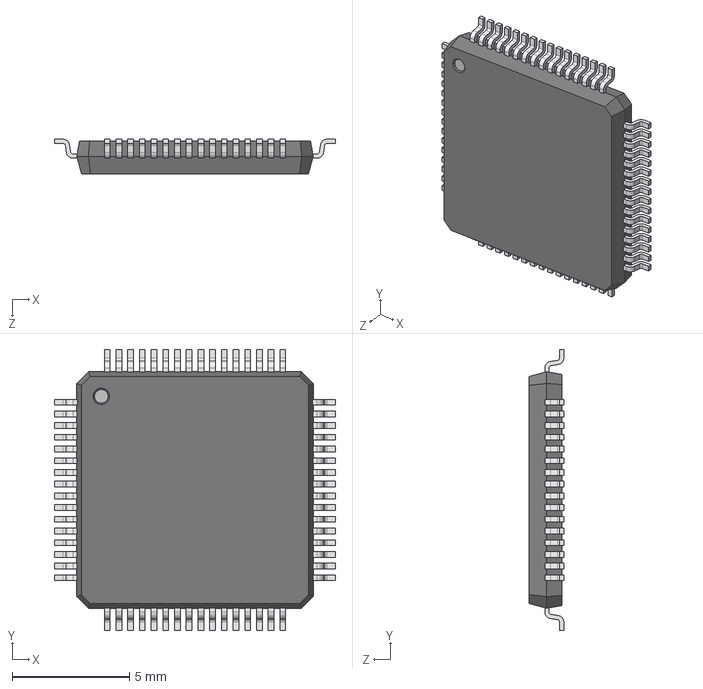
[picture p65: CAD file, 2016-09-23]
3D/STEP/User Library-lqpf64.STEP
12.0 x 12.0 x 1.48 mm
