HydroPWNics/footprints/3D/STEP/B3B-PH-K-S.STEP

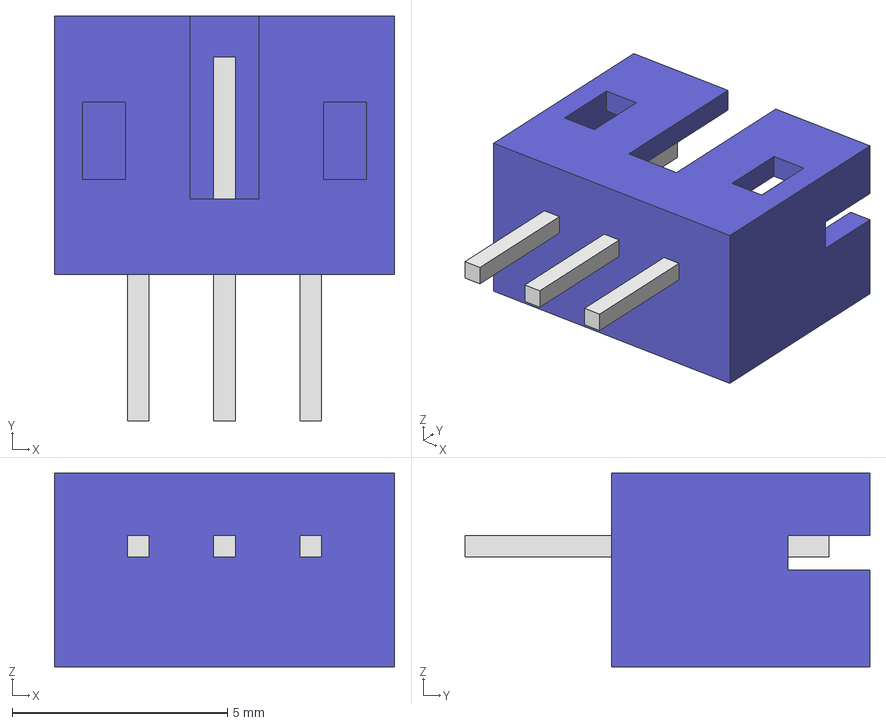
[picture p66: CAD file, 2016-09-23]
3D/STEP/B3B-PH-K-S.STEP
7.90 x 9.40 x 4.50 mm
