HydroPWNics/footprints/3D/STEP/B4B-PH-K-S.STEP

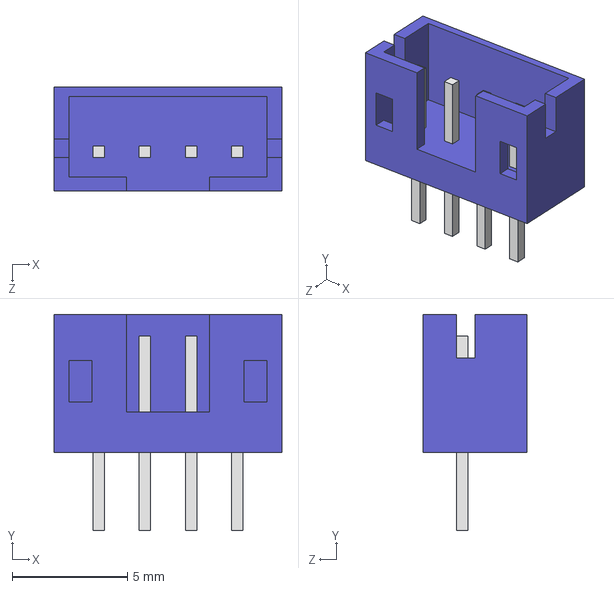
[picture p67: CAD file, 2016-09-23]
3D/STEP/B4B-PH-K-S.STEP
9.90 x 9.40 x 4.50 mm
