HydroPWNics/footprints/3D/STEP/SOT457.STEP

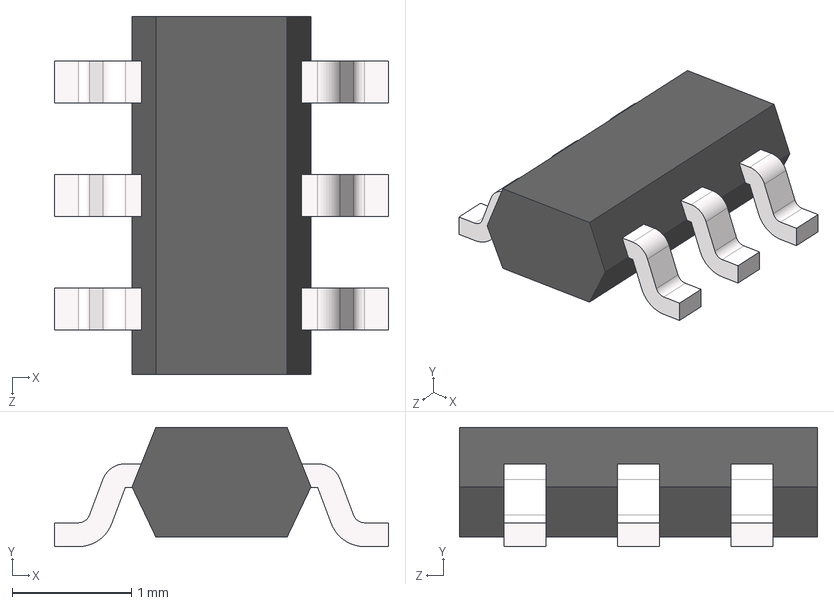
[picture p68: CAD file, 2016-09-23]
3D/STEP/SOT457.STEP
2.80 x 1.00 x 3.00 mm
User Library-SOT457_body
User Library-SOT457_pin x 6
