HydroPWNics/footprints/3D/STEP/CAPC-0603-T0.9-BN.stp

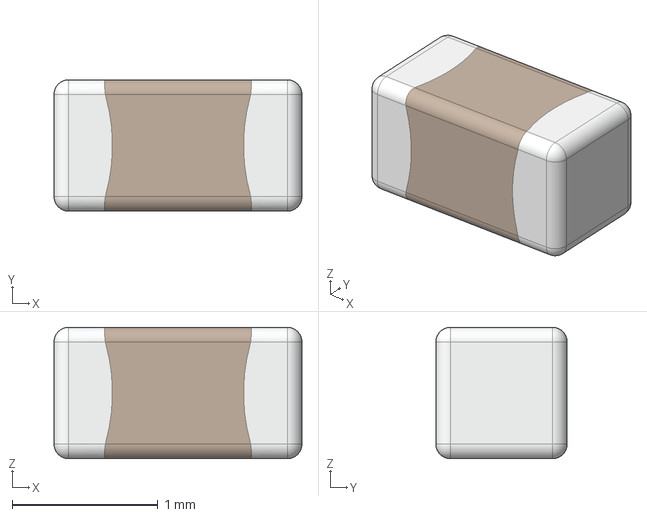
[picture p69: CAD file, 2016-09-13]
3D/STEP/CAPC-0603-T0.9-BN.stp
1.70 x 0.9 x 0.9 mm
