HydroPWNics/footprints/3D/STEP/RES0805.stp

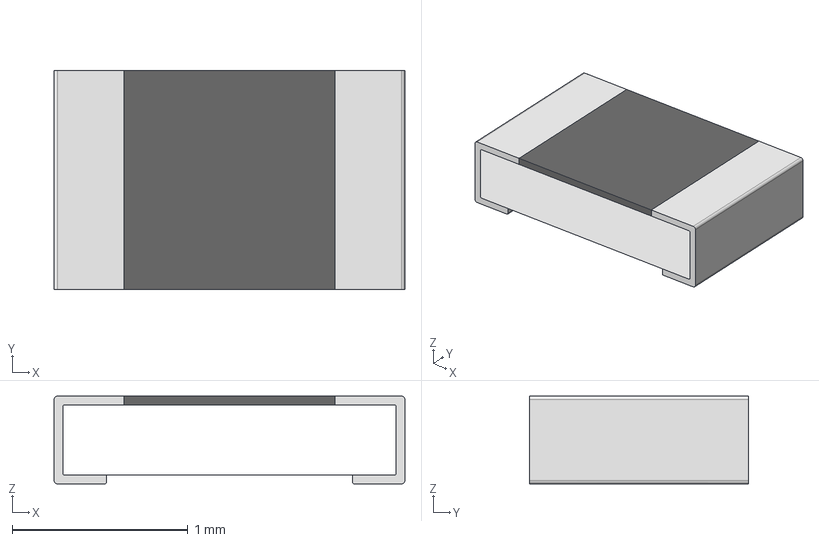
[picture p70: CAD file, 2016-09-13]
3D/STEP/RES0805.stp
2.00 x 1.25 x 0.5 mm
