HydroPWNics/footprints/3D/STEP/CAPC-0805-T0.7-BN.stp

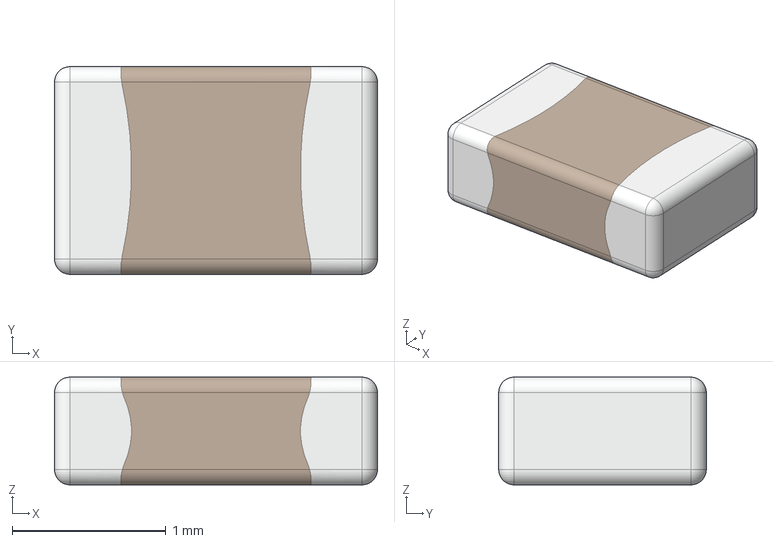
[picture p71: CAD file, 2016-09-13]
3D/STEP/CAPC-0805-T0.7-BN.stp
2.10 x 1.35 x 0.7 mm
