HydroPWNics/footprints/3D/STEP/LED 0603 single color.stp

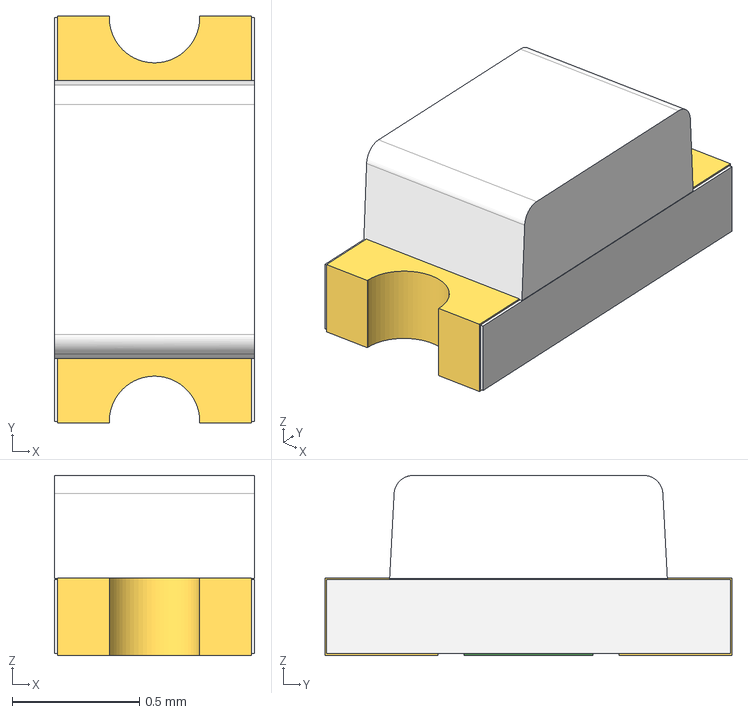
[picture p72: CAD file, 2016-09-13]
3D/STEP/LED 0603 single color.stp
0.787 x 1.60 x 0.709 mm
