HydroPWNics/footprints/3D/STEP/FB-0402-T0.55-BN.stp

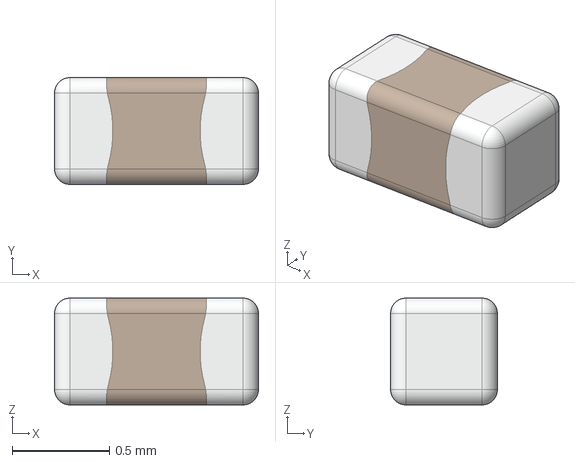
[picture p73: CAD file, 2016-09-13]
3D/STEP/FB-0402-T0.55-BN.stp
1.05 x 0.55 x 0.55 mm
