HydroPWNics/footprints/3D/STEP/RES0603.stp

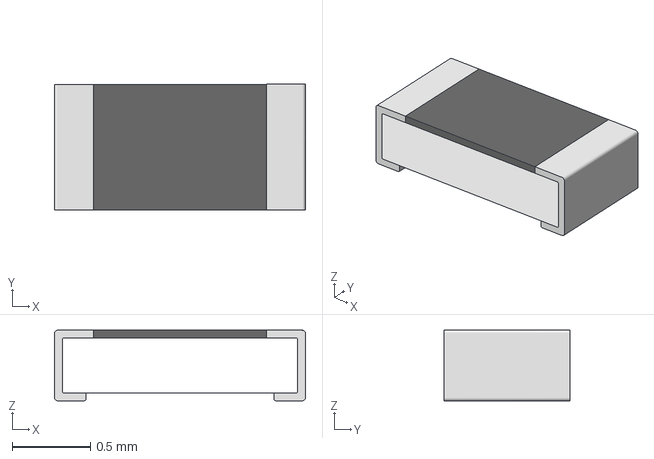
[picture p74: CAD file, 2016-09-13]
3D/STEP/RES0603.stp
1.60 x 0.8 x 0.45 mm
