HydroPWNics/footprints/3D/STEP/CAPC-1206-T0.95-BN.stp

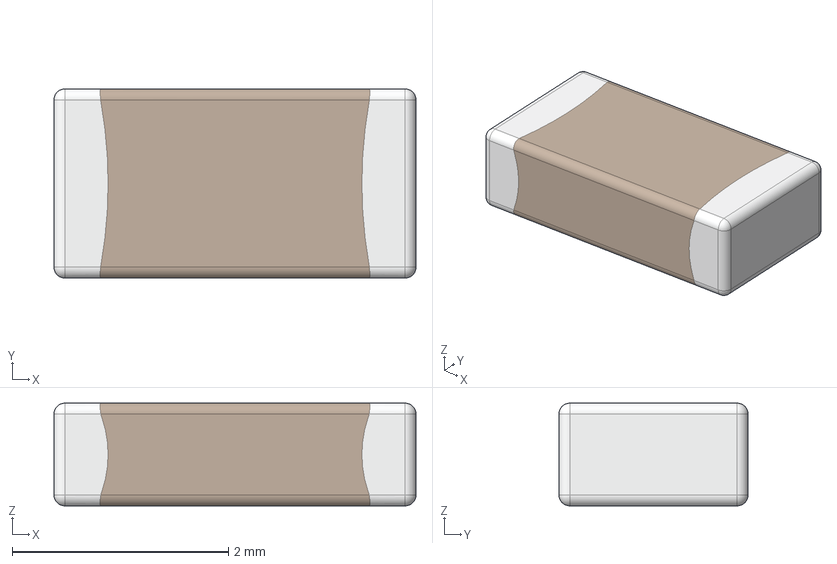
[picture p75: CAD file, 2016-09-13]
3D/STEP/CAPC-1206-T0.95-BN.stp
3.35 x 1.75 x 0.95 mm
