HydroPWNics/footprints/3D/STEP/RES0402.stp

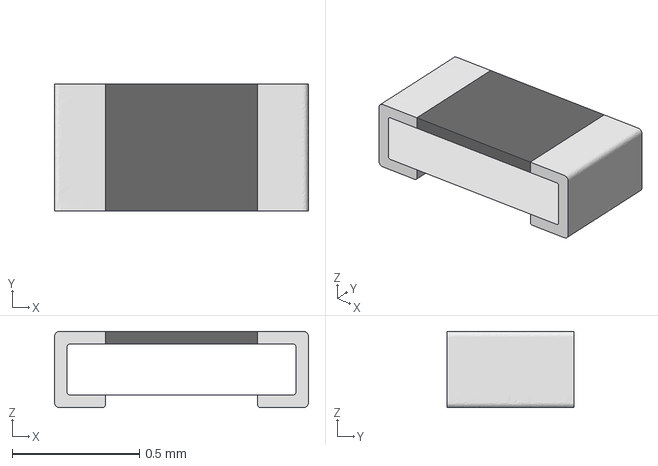
[picture p76: CAD file, 2016-09-13]
3D/STEP/RES0402.stp
1.00 x 0.5 x 0.3 mm
