HydroPWNics/footprints/3D/STEP/B3U_1000P[].step

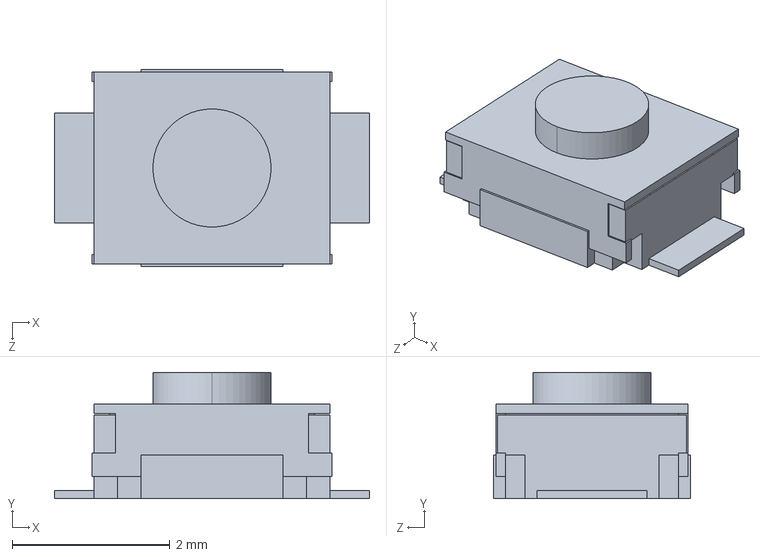
[picture p77: CAD file, 2016-09-13]
3D/STEP/B3U_1000P[].step
4.00 x 1.60 x 2.50 mm
