HydroPWNics/footprints/(list of files, cad)

Other CAD files:
3D/STEP/CAP_EEFC_G.stp
3D/STEP/CAP_EEFC_G-L.stp
3D/STEP/CAP1210.STEP
3D/STEP/0031-7701-11 - 0031-7701-11.step
3D/STEP/0031-7701-11_AP103.STEP
3D/STEP/ABS05 - ABS05.step
3D/STEP/S4B-PH-SM4-TB - S4B-PH-SM4.step
3D/STEP/ABS05_AP103.STEP
3D/STEP/User Library-LTST-C193KRKT.step
3D/STEP/User Library-LTST-C193KSKT.step
3D/STEP/User Library-LTST-C193KGKT.step
3D/STEP/NICHICON_UWT1V221MNL1GS.STEP
3D/STEP/ABM10 - ABM10.step
3D/STEP/MS-026ACD.stp
3D/STEP/ABM10.STEP
3D/STEP/User Library-TQFP-48 - User Library-TQFP-48_pins_TQFP_pin_TQFP_022x07_1_19.step
3D/STEP/S6B-PH-SM4-TB(LF)(SN).step
3D/STEP/S6B-PH-SM4-TB.STEP
3D/STEP/TQFP-32.STEP
3D/STEP/STEP-36103205-rev1.stp
3D/STEP/User Library-TQFP-48.STEP
3D/STEP/SM06B-SRSS-TB(LF)(SN).step
3D/STEP/WIN_SS-8-L.stp
3D/STEP/WIN_SS-8.stp
3D/STEP/WIN_ZP-8.stp
3D/STEP/WIN_ZP-8-L.stp
3D/STEP/1757242.stp
3D/STEP/20021121-00010XXLFc.stp
3D/STEP/475890001.stp
3D/STEP/901512116.stp
3D/STEP/BQ24210_.step
3D/STEP/OV07725-V28A_.step
3D/STEP/SOT23-6.stp
