HydroPWNics/footprints/(commit log)

2016-03-31 Libraryies Updated
    Libraries updated with STM32 footprint and footprints for all related
    supporting components.
2016-04-07 More Footprints
    More footprints added for SunLeaf Project
2016-04-29 JST
    additional JST connectors added
2016-05-02 More
    ESD suppression IC added, and 200 ohm resistor.
2016-05-06 More Added
    Bunch of footprints added for HydroPWNics Beaglebone Cape design
2016-05-24 Additions and Cleanup
    New USB port added, and datafields on all components in SunLeaf cleaned
    up and made consistent for auto BOM and PnP plot generation.
2016-06-05 Footprint fix
    3 pin 2.54mm spacing header, 3D model surface offset adjusted for
    accurate 3D model generation.
2016-08-19 KiCAD Port Started
    Porting over all component libraries associated with all HydroPWNics
    projects (SunLeaf/AuquaLeaf/ HydroPWNics Cape) to KiCAD
    [HydroPWNics_Components.kicad_pcb, HydroPWNics_Components.sch]
2016-08-22 KiCAD
    more KiCAD dev
2016-08-23 More Footprints
    More components from SunLeaf created in KiCAD
2016-09-13 Tweaks and 3D
    IPC passive footprints tweaked with 3D file refrence and adde component
    outlines. Also soldermask expansion rule set on each passive component.
    set to 0.102mm
    [B3U_1000P[].step, CAPC-0402-T0.55-BN.stp, CAPC-0603-T0.9-BN.stp, CAPC-0805-T0.7-BN.stp, CAPC-1206-T0.95-BN.stp, LED 0603 single color.stp, RES0402.stp, RES0603.stp]
2016-09-18 3D and more footprints
    more footprints ported to KiCAD libraries, also 3D content added.
    [475890001.stp]
2016-09-23 3D and Soldermask Expansion
    More 3D models added ans soldermask expansion for footprint pads
    adjusted.
    [B2B-PH-K-S.STEP, B3B-PH-K-S.STEP, B4B-PH-K-S.STEP, SOT457.STEP, User Library-lqpf64.STEP]
2016-09-29 3D
    3D files added to components
    [20021121-00010XXLFc.stp, ABM3B.STEP, ABS07.STEP, BQ24210_.step, FB-0402-T0.55-BN.stp, SOD-123FL.STEP, SOD-323.STEP, SOT23-3.stp]
2016-09-30 More 3D
    more 3D, ESP QFN
    [QFN-32 V6.stp]
2016-10-14 More footprints
    RF components for 2.4GHZ radios created and added. 3D data added to
    various components.
    [S2B-PH-K-S.STEP, S3B-PH-K-S.STEP, User Library-QFN48_7x7.step, WIN_ZP-8-L.stp, WIN_ZP-8-M.stp, WIN_ZP-8.stp]
2016-10-18 3D and More
    More footprins and 3D model data added, parts pertaining to the Aria
    series of boards.
    [User Library-ESP_12_E.STEP, WIN_SS-8-L.stp, WIN_SS-8-M.stp, WIN_SS-8.stp]
2016-10-28 Components and 3D
    New component symbols and footprints created for new boards and updates
    to existing designs. 3D file data added for those parts as well.
    [CSS-1210TB.stp, CUS-12TB.stp, SOIC08 narrow.stp, SOIC10 narrow.stp, SOIC14 narrow.stp, SOIC16 narrow.stp]
2016-10-29 Coilcraft Inductors
    RF grade inductors for sub 1 ghz radio projects added, all Corilcraft
    O402CS products. Components include 3D models from Coilcraft.
    [Coilcraft-0402CS.step]
2016-10-30 RF Baluns
    RF Baluns added for all formats of sub 1GHZ coms the ADF7023 can
    perform. 3D models also added.
    [Johanson_Tech_Balun.step]
2016-10-30 Baluns corected
    Balun schematic symbolds corrected with proper pinout.
2016-10-31 More
    More footrprints and symbolds. Couple LDOs added with 3d models, RF
    capacitors for ADF7023 added as well.
    [SOT23-5.stp]
2016-11-01 Adjustment
    BATJFILM diode pins reversed to match up with schematic symbol
2016-11-11 Components and 3D models
    Various 3D models and additional components have been added.
    [ABM10 - ABM10.step, ABM10.STEP, ABM10_AP103.STEP, ABM12.step, Laird BMI-S-209-C.step, Laird BMI-S-209-F.step, MS-026ABA.stp, MS-026ACB.stp]
2016-12-30 More components added
    More footprints and components added, look at file changes for details.
    [901512116.stp, ABS05 - ABS05.step, ABS05.STEP, ABS05_AP103.STEP, Coilcraft-XFL3012.step, NICHICON_ALU_CAP_1.step, NICHICON_UWT1V221MNL1GS.STEP, S4B-PH-SM4-TB - S4B-PH-SM4.step]
2017-01-04 More added
    More added, loook at file changes for details
    [0031-7701-11 - 0031-7701-11.step, 0031-7701-11.STEP, 0031-7701-11_AP103.STEP, 1206_RES.stp, 1757242.stp, SOIC4.step, User Library-DO-214AA_SMB.step, User Library-FSM4JSMATR - TE Connectivity - SPST 6mm Tactile Switch.step]
2017-01-09 More
    See file changes as per usual
    [C1210.step, CAP1210.STEP, Coilcraft-LPS3015.step, LQM2HP_J0.stp, XFL4020.step]
2017-01-09 More
    OV07725 lens mount added. OV07725 lens mount origin offset values added
    to ECO layer of footprint.
    [OV07725-V28A_.step]
2017-01-13 PMIC
    Ti PMIC added, work in progress.
    [SML-LXLC1206.stp]
2017-01-24 Components
    Components created and added for Ti PMIC circuit on ZyncMV project. for
    dtails look at files altered/added
    [ABS06.STEP, Coilcraft-XAL6030.step, VLCF5020T-100M1R1-1.step]
2017-01-26 LDO
    3V fixed LDO added. For powering analog voltage of CMOS image sensor on
    ZyncMV
2017-02-06 Resistors and PMIC
    new PMIC component created, reistors for reference design for powering
    Zynq SoC created and added to the library.
    [User Library-tsx-3225-1.step, xc7z010clg225pkg.csv]
2017-02-07 PMIC Caps
    Capacitors added for new PMIC on the ZyncMV project.
2017-02-10 More parts
    inductors and capacitors pertainting to Ti PMIC added
2017-02-12 PMIC parts
    more parts for Zynq PMIC added, various capacitors etc
2017-02-14 MOre
    panasonic cap footprint made and STEP added.
    [CAP_EEFC_G-L.stp, CAP_EEFC_G-M.stp, CAP_EEFC_G.stp]
